elpimous/yellow_robot/Feet_mold_for_silicon.md

# Mold HowTo for Legs_V4 ONLY
 
Mold parts :
------------------

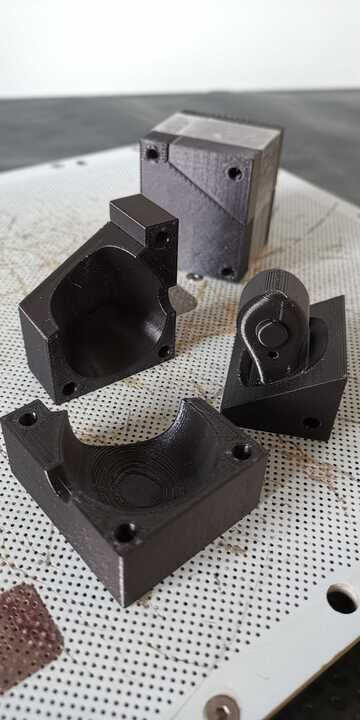
[picture p10: OpenQuad_V2/images/mold1.jpg]
Openquad

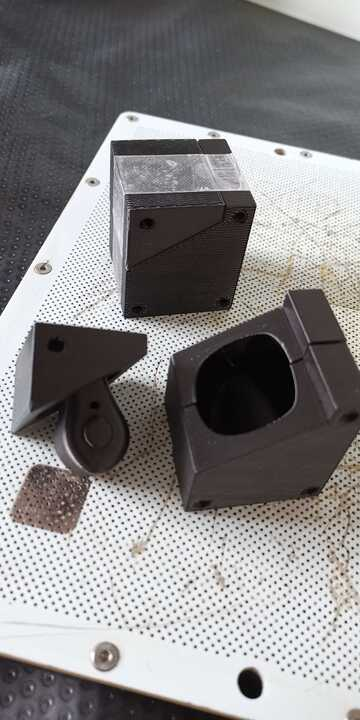
[picture p11: OpenQuad_V2/images/mold2.jpg]
Openquad


Silicon process :
------------------

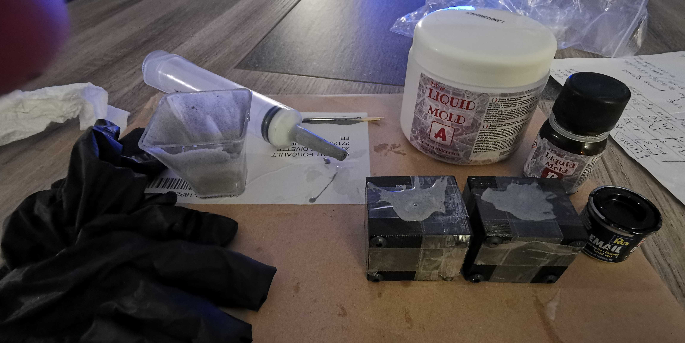
[picture p12: OpenQuad_V2/images/mold_product.jpg]
Openquad

	
No need oil or other product, to help opening mold !!

You need to clean interior mold, the better you can, 'cause the silicon prints all details !

use 100/5 :  ex. use 30grs silicon with 1.5grs hardener

you can color it (using paint for plastic parts)

Just wait at least 24h before opening mold (36h should be better ?!)

It seems that if you use a bit of acrylic paint, silicon will be dry in 5 hours ?! (didn't tested)

## After 24H...

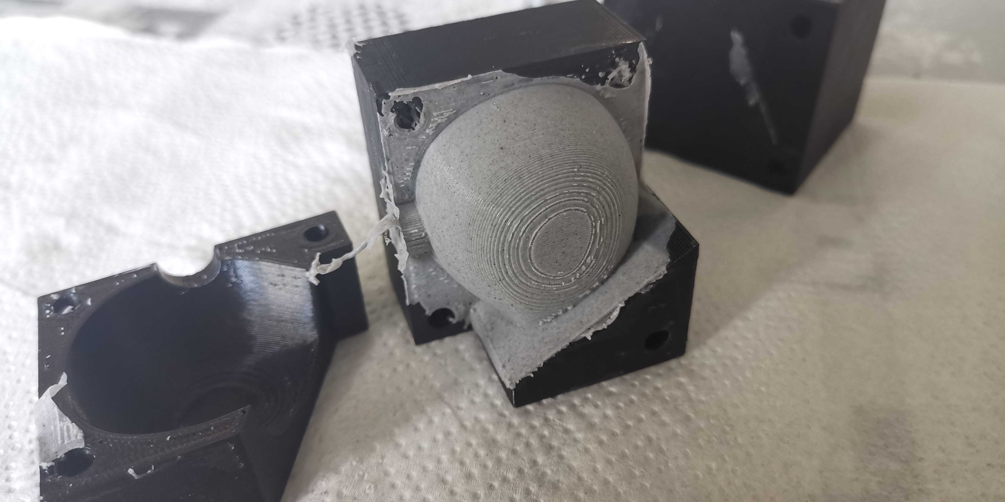
[picture p13: OpenQuad_V2/images/silicon_finished.jpg]
Openquad


Result :
--------

result is very nice, and perfect for Yellow feet !!

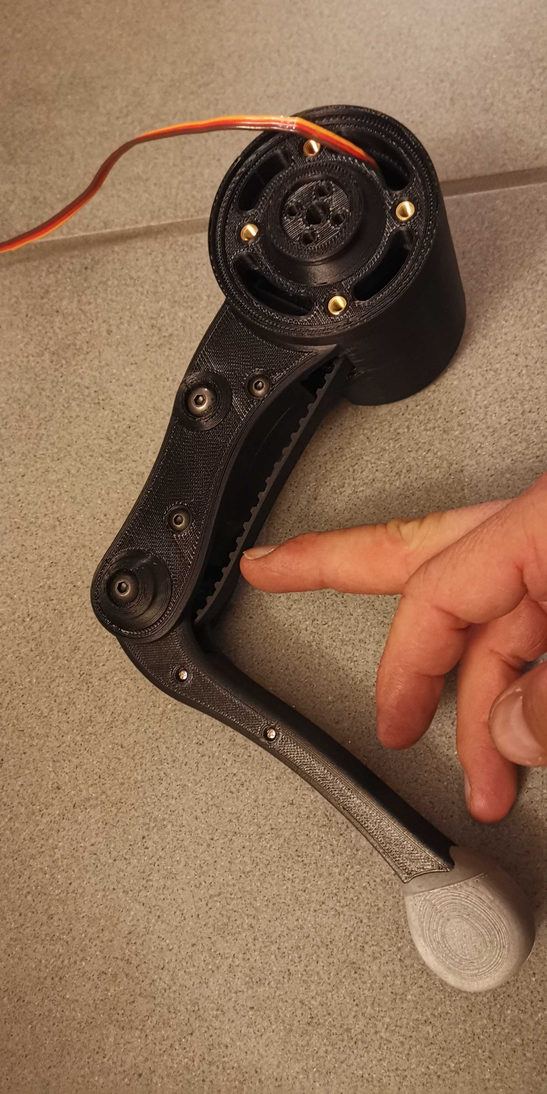
[picture p14: OpenQuad_V2/images/leg_with_silicon.jpg]
Openquad

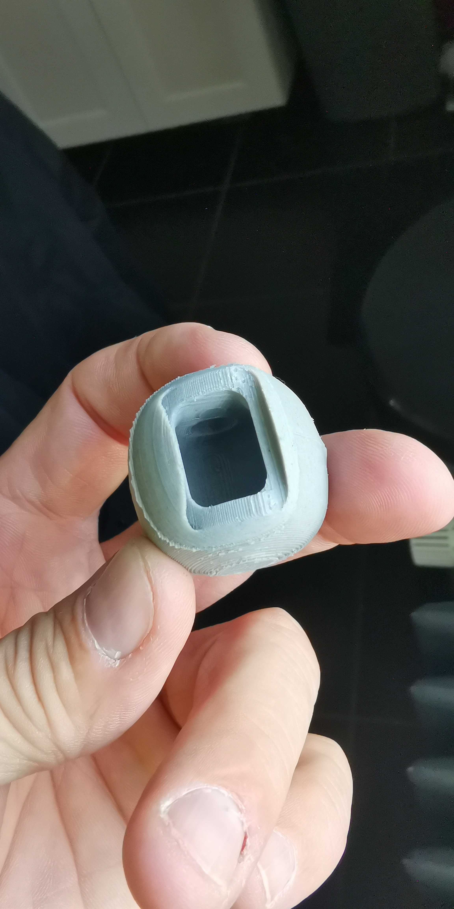
[picture p15: OpenQuad_V2/images/silicon1.jpg]
Openquad

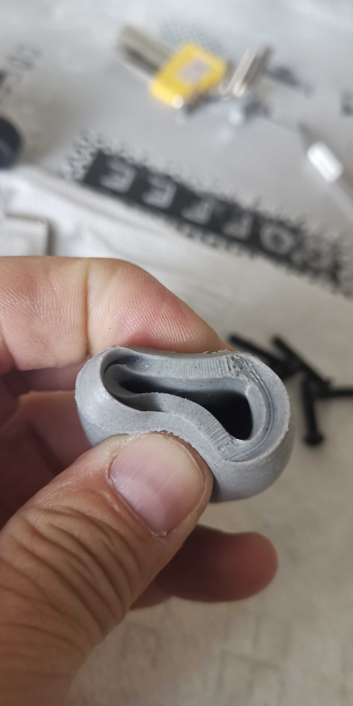
[picture p16: OpenQuad_V2/images/silicon2.jpg]
Openquad
