elpimous/yellow_robot/OpenQuad_V2/robot_parts/L_leg/img_20200823_153159.jpg

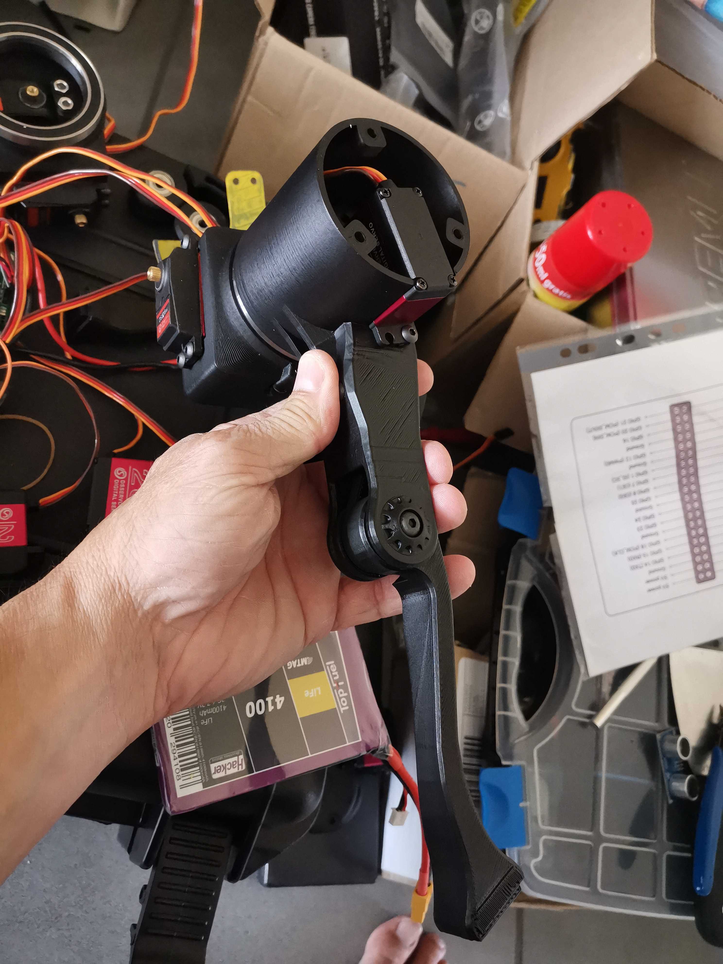
OpenQuad_V2/robot_parts/L_leg/img_20200823_153159.jpg
