elpimous/yellow_robot/OpenQuad_V2/robot_parts/L_leg/img_20200826_154630.jpg

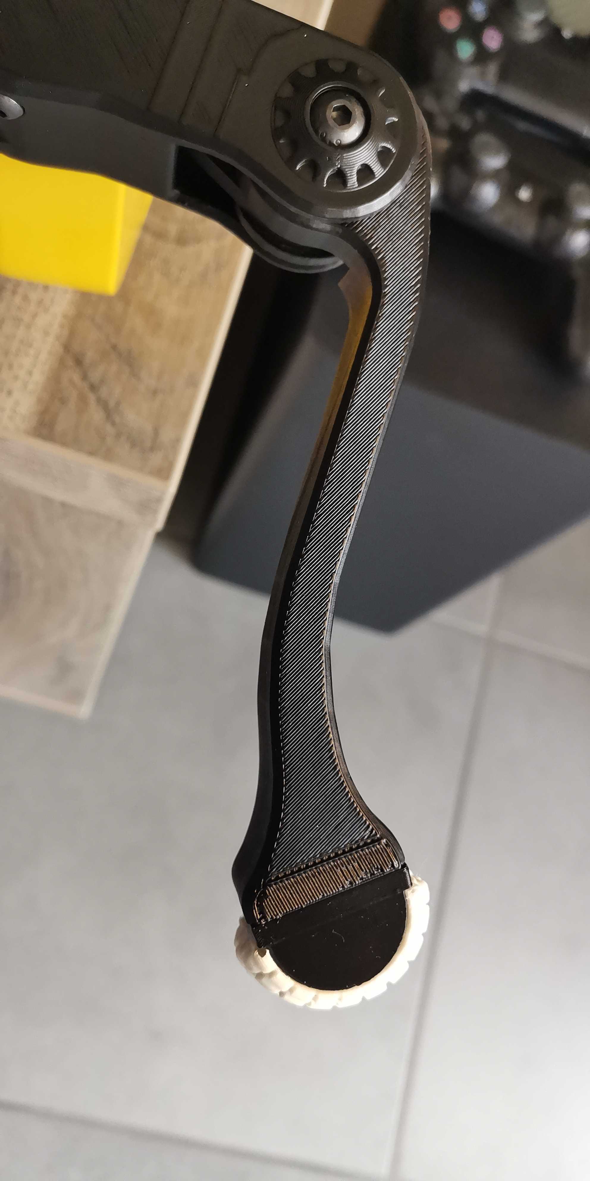
OpenQuad_V2/robot_parts/L_leg/img_20200826_154630.jpg
