elpimous/yellow_robot/OpenQuad_V2/robot_parts/R_legs_v4/img_20201010_220422.jpg

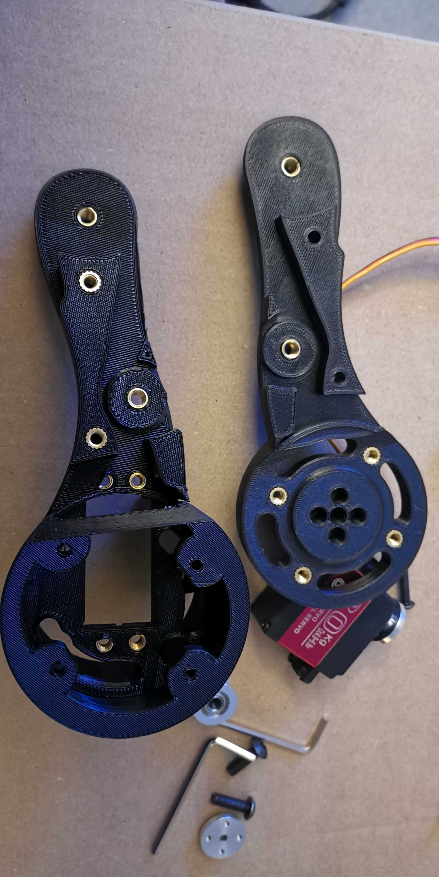
OpenQuad_V2/robot_parts/R_legs_v4/img_20201010_220422.jpg
