elpimous/yellow_robot/OpenQuad_V2/yellow_ros/src/mini_ros/stl/mainbody.stl

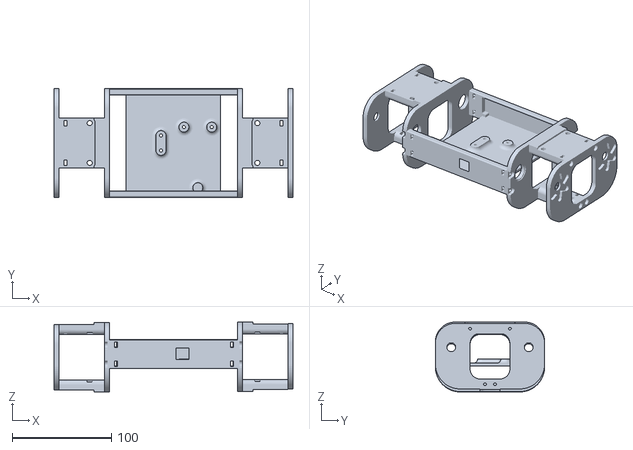
[picture p36: CAD file, 2020-09-23]
OpenQuad_V2/yellow_ros/src/mini_ros/stl/mainbody.stl
240.7 x 110.0 x 70.4
