elpimous/yellow_robot/OpenQuad_V2/yellow_ros/src/spotmicro/util/pybullet_data/assets/urdf/stl/rearmain.stl

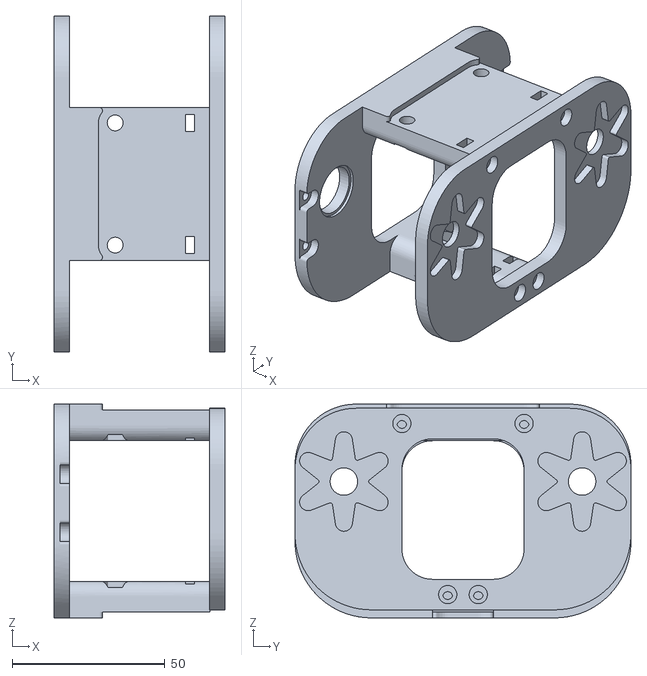
[picture p37: CAD file, 2020-09-23]
OpenQuad_V2/yellow_ros/src/spotmicro/util/pybullet_data/assets/urdf/stl/rearmain.stl
55.9 x 110.0 x 70.0
