elpimous/yellow_robot/OpenQuad_V2/yellow_ros/src/spotmicro/util/pybullet_data/assets/urdf/stl/rplidar_main.stl

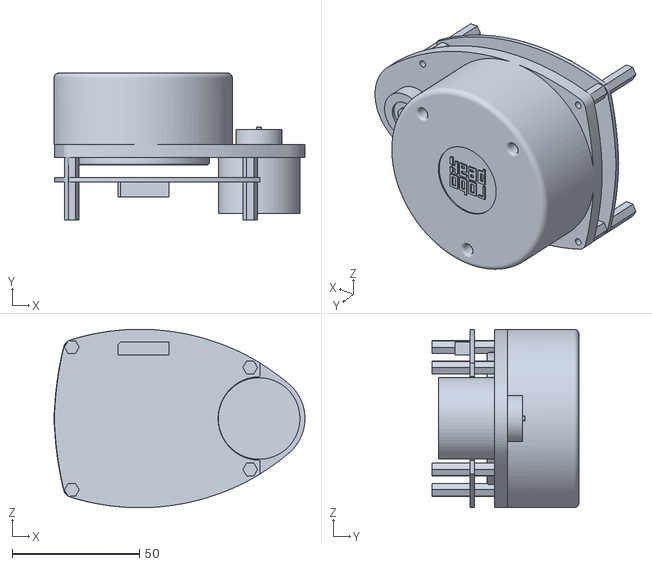
[picture p38: CAD file, 2020-09-23]
OpenQuad_V2/yellow_ros/src/spotmicro/util/pybullet_data/assets/urdf/stl/rplidar_main.stl
98.5 x 57.7 x 70.0
