elpimous/yellow_robot/OpenQuad_V2/robot_parts/body/back_cover/back_cover_v2.STL

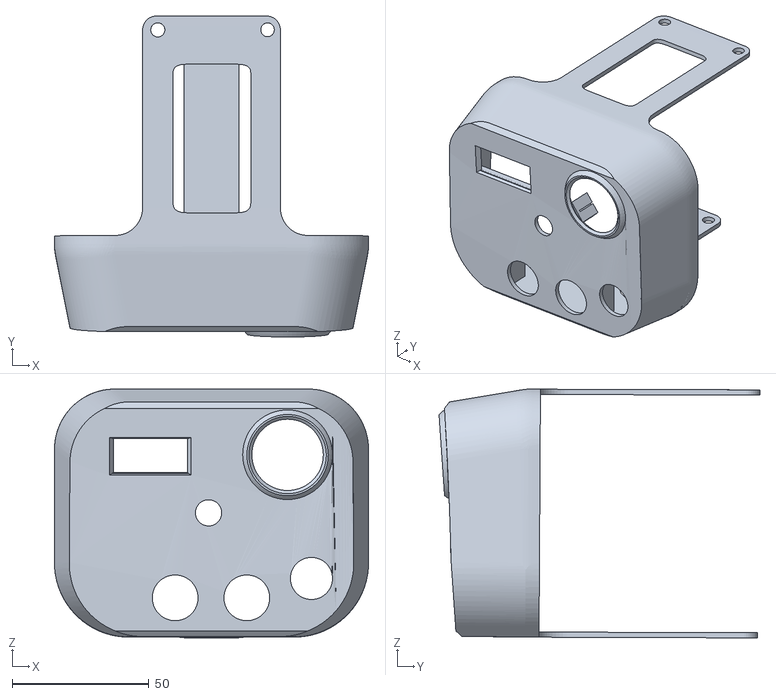
[picture p39: CAD file, 2020-08-23]
OpenQuad_V2/robot_parts/body/back_cover/back_cover_v2.STL
114.8 x 117.3 x 91.0
