elpimous/yellow_robot/OpenQuad_V2/robot_parts/body/body/RPI4+Mano_board_plateform_v2.STL

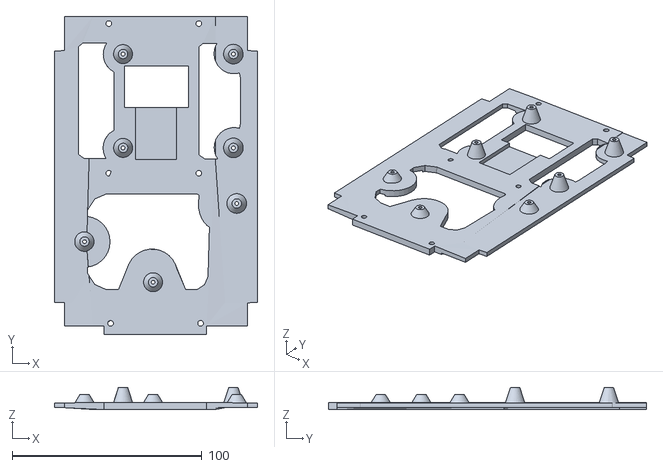
[picture p40: CAD file, 2020-09-27]
OpenQuad_V2/robot_parts/body/body/RPI4+Mano_board_plateform_v2.STL
106.9 x 167.5 x 11.6
