elpimous/yellow_robot/OpenQuad_V2/robot_parts/body/head_cover/front_cover_v2.STL

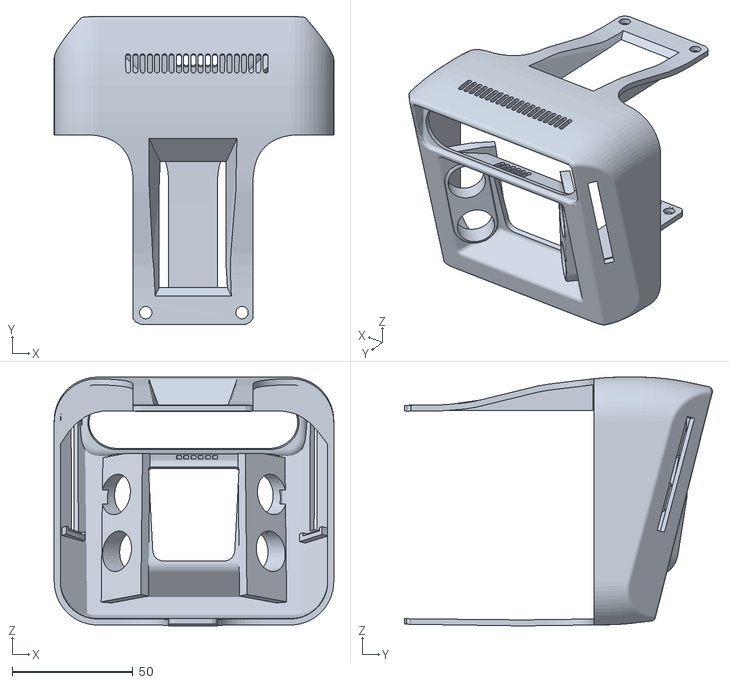
[picture p41: CAD file, 2020-10-11]
OpenQuad_V2/robot_parts/body/head_cover/front_cover_v2.STL
116.0 x 127.8 x 103.2
