elpimous/yellow_robot/OpenQuad_V2/robot_parts/L_leg/hip_v2.STL

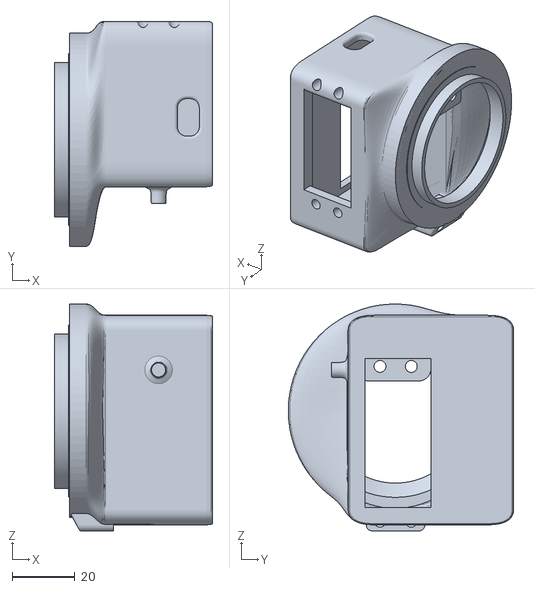
[picture p42: CAD file, 2020-08-23]
OpenQuad_V2/robot_parts/L_leg/hip_v2.STL
50.6 x 72.1 x 72.6
