elpimous/yellow_robot/OpenQuad_V2/robot_parts/R_legs_v4/R_shoulder_1-2.stl

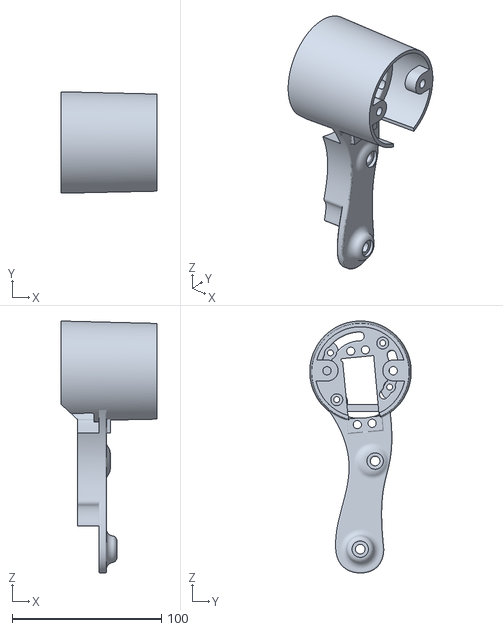
[picture p43: CAD file, 2020-10-18]
OpenQuad_V2/robot_parts/R_legs_v4/R_shoulder_1-2.stl
64.2 x 68.1 x 169.1
