elpimous/yellow_robot/OpenQuad_V2/robot_parts/universel/foot_mold_for_V4_legs/mold_2-2.stl

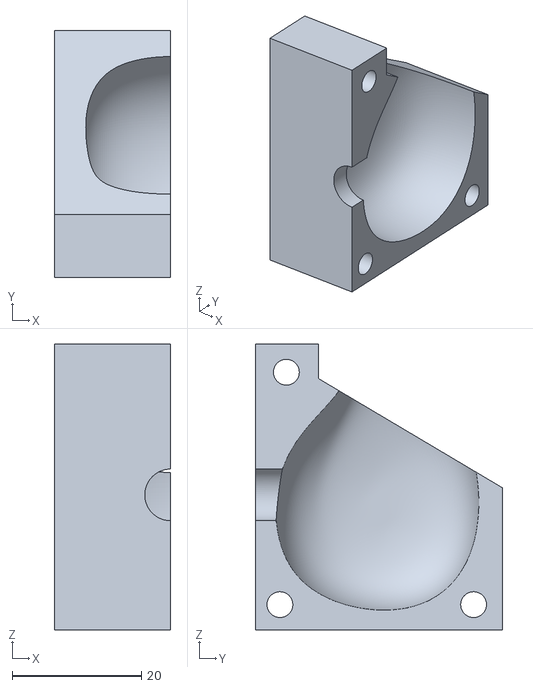
[picture p44: CAD file, 2020-10-21]
OpenQuad_V2/robot_parts/universel/foot_mold_for_V4_legs/mold_2-2.stl
18.0 x 38.2 x 44.3
