elpimous/yellow_robot/OpenQuad_V2/robot_parts/universel/leg_pulley_for_V4.stl

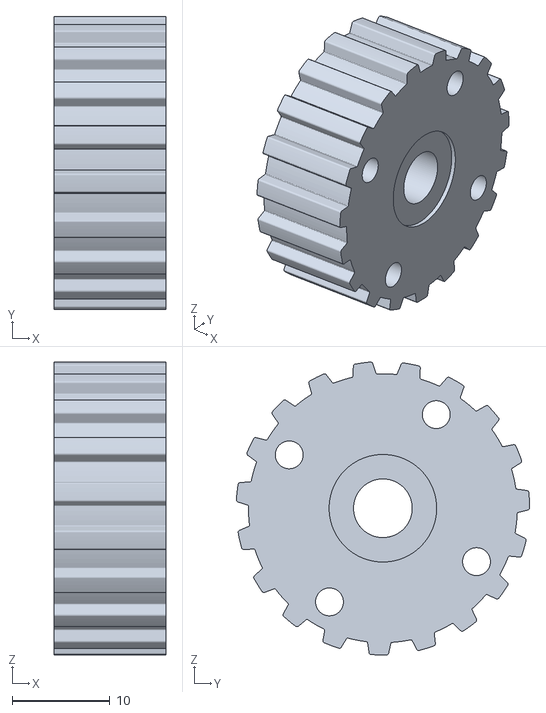
[picture p45: CAD file, 2020-10-21]
OpenQuad_V2/robot_parts/universel/leg_pulley_for_V4.stl
11.4 x 30.0 x 30.0
