elpimous/yellow_robot/OpenQuad_V2/robot_parts/universel/stl_parts_for_3d_soft/Neopixel8x.stl

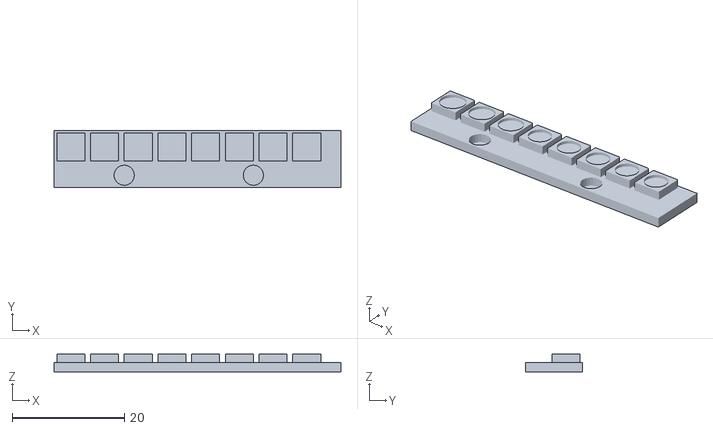
[picture p46: CAD file, 2020-09-03]
OpenQuad_V2/robot_parts/universel/stl_parts_for_3d_soft/Neopixel8x.stl
51.1 x 10.2 x 3.20
