elpimous/yellow_robot/OpenQuad_V2/yellow_ros/src/mini_ros/stl/OpenQuadruped/SERVO_WITH_COVER.stl

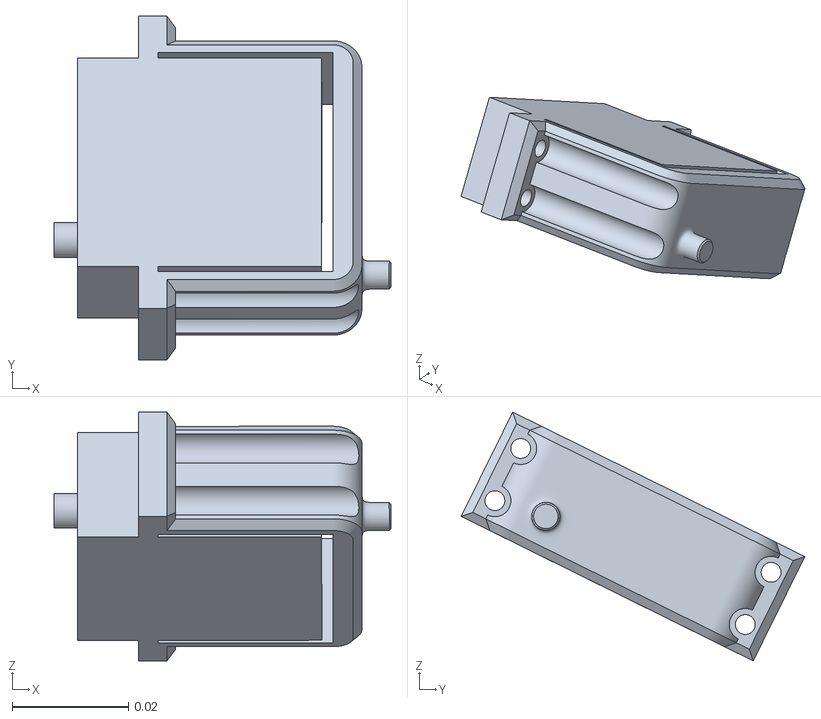
[picture p47: CAD file, 2020-09-23]
OpenQuad_V2/yellow_ros/src/mini_ros/stl/OpenQuadruped/SERVO_WITH_COVER.stl
0.0579 x 0.0591 x 0.0428
