elpimous/yellow_robot/OpenQuad_V2/yellow_ros/src/spot_bullet/src/mini_bullet/terrain9735.obj

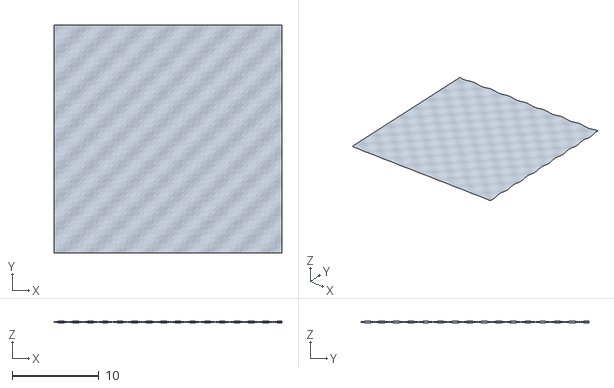
[picture p48: CAD file, 2020-09-23]
OpenQuad_V2/yellow_ros/src/spot_bullet/src/mini_bullet/terrain9735.obj
26.3 x 26.3 x 0.24
