elpimous/yellow_robot/OpenQuad_V2/yellow_ros/src/spotmicro/util/pybullet_data/assets/urdf/stl/backpart.stl

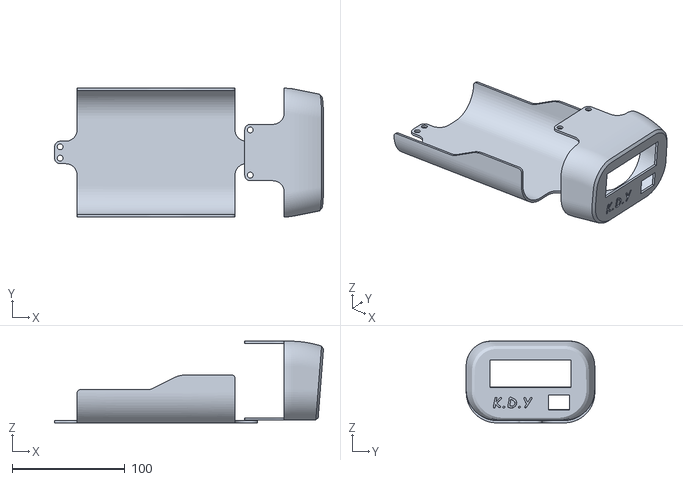
[picture p49: CAD file, 2020-09-23]
OpenQuad_V2/yellow_ros/src/spotmicro/util/pybullet_data/assets/urdf/stl/backpart.stl
238.4 x 114.1 x 72.5
