elpimous/yellow_robot/OpenQuad_V2/yellow_ros/src/spotmicro/util/pybullet_data/assets/urdf/stl/OpenQuadruped/RIGHT_HIP.stl

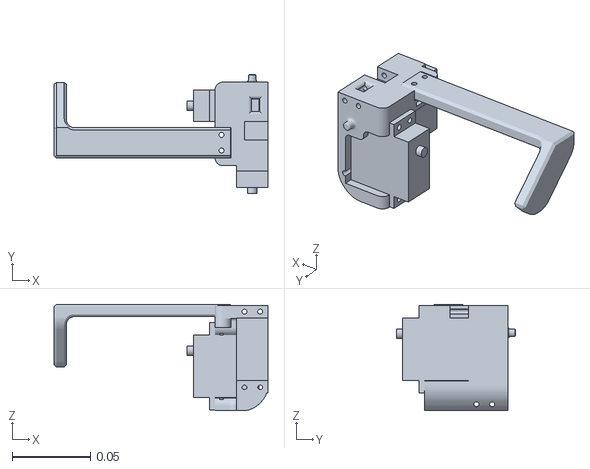
[picture p50: CAD file, 2020-09-23]
OpenQuad_V2/yellow_ros/src/spotmicro/util/pybullet_data/assets/urdf/stl/OpenQuadruped/RIGHT_HIP.stl
0.137 x 0.0762 x 0.068
