elpimous/yellow_robot/OpenQuad_V2/yellow_ros/src/spotmicro/util/pybullet_data/plane100.obj

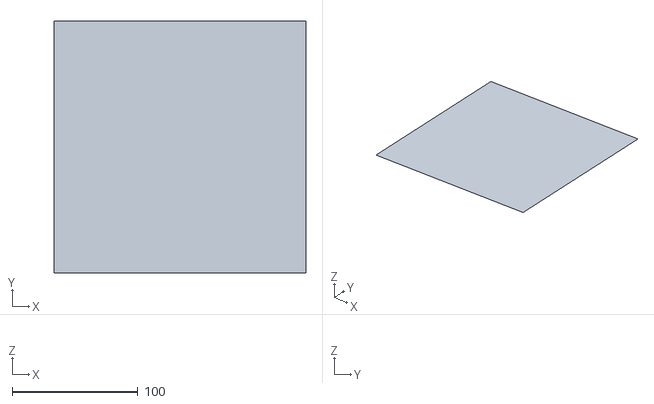
[picture p51: CAD file, 2020-09-23]
OpenQuad_V2/yellow_ros/src/spotmicro/util/pybullet_data/plane100.obj
200.0 x 200.0 x 0
