elpimous/yellow_robot/OpenQuad_V2/robot_parts/body/body/D435_fix_plate_v2.STL

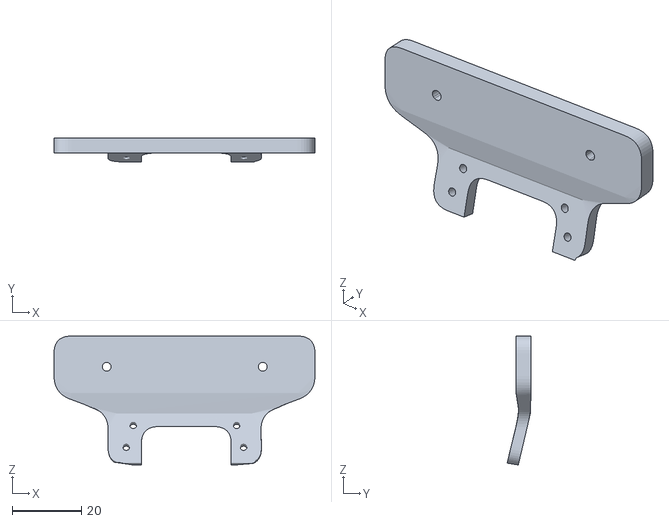
[picture p52: CAD file, 2020-09-03]
OpenQuad_V2/robot_parts/body/body/D435_fix_plate_v2.STL
75.2 x 6.87 x 37.1
