elpimous/yellow_robot/OpenQuad_V2/robot_parts/body/body_cover/bottom_cover_v2_2-2.STL

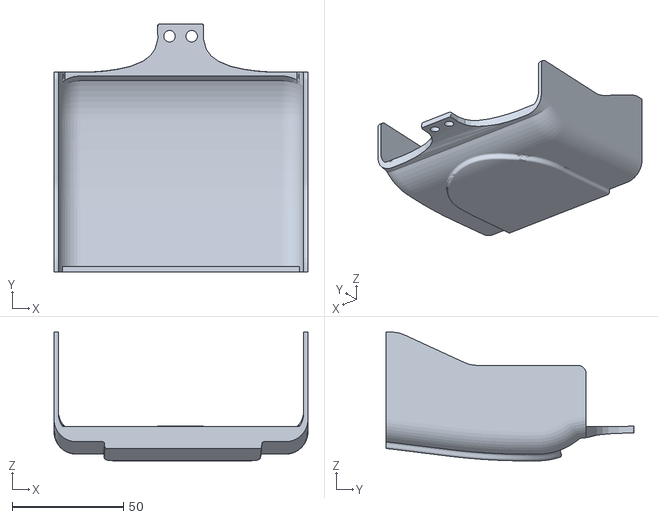
[picture p53: CAD file, 2020-09-03]
OpenQuad_V2/robot_parts/body/body_cover/bottom_cover_v2_2-2.STL
114.0 x 111.5 x 57.8
