elpimous/yellow_robot/OpenQuad_V2/robot_parts/body/head_cover/head_speaker_grill_v2.STL

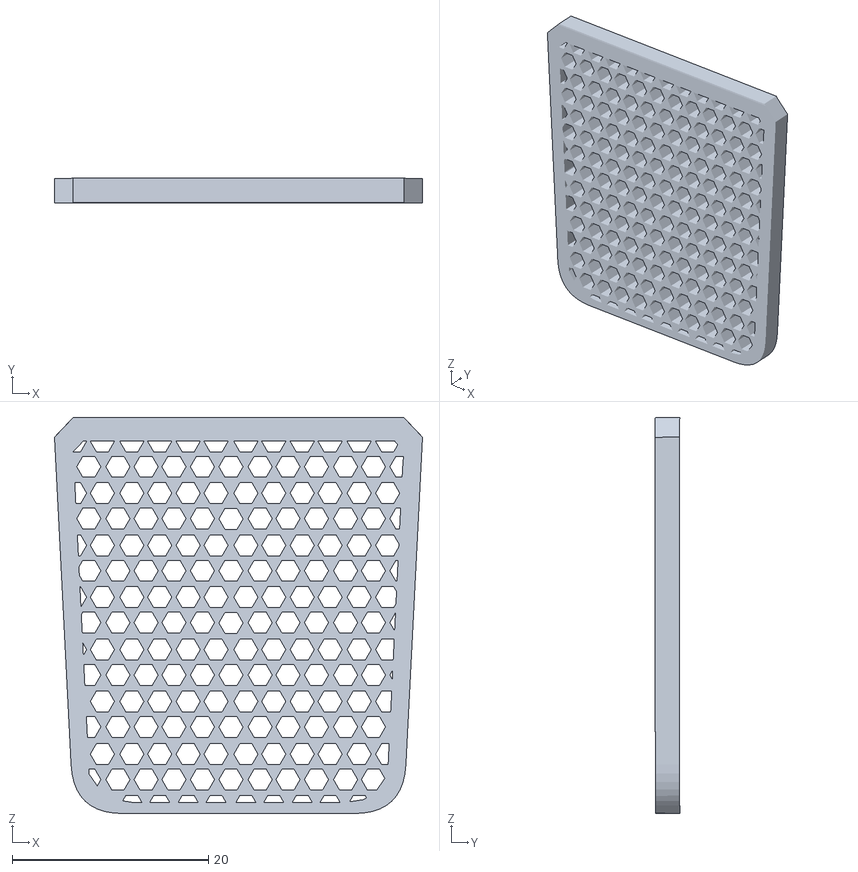
[picture p54: CAD file, 2020-09-03]
OpenQuad_V2/robot_parts/body/head_cover/head_speaker_grill_v2.STL
37.5 x 2.53 x 40.3
