elpimous/yellow_robot/OpenQuad_V2/robot_parts/L_leg/shoulder_cover_v2.STL

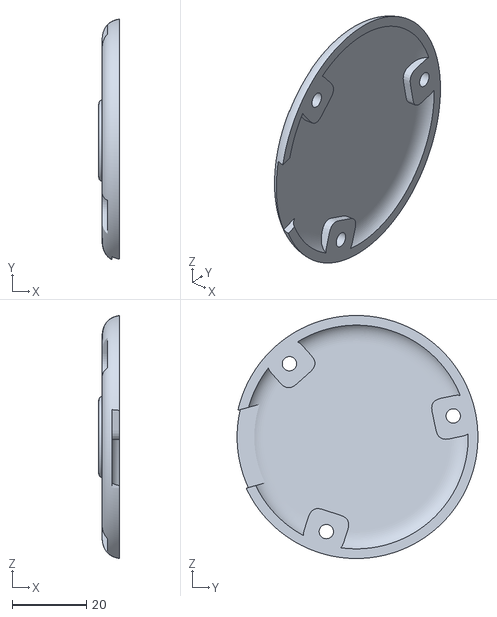
[picture p55: CAD file, 2020-08-23]
OpenQuad_V2/robot_parts/L_leg/shoulder_cover_v2.STL
5.58 x 64.8 x 65.4
