elpimous/yellow_robot/OpenQuad_V2/robot_parts/R_legs_v4/R_leg_2-2.stl

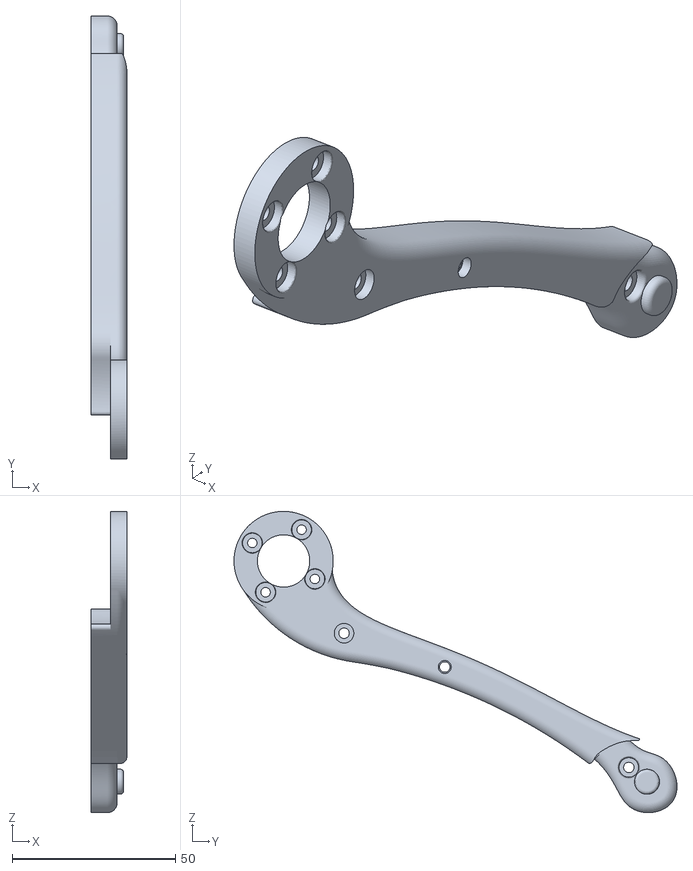
[picture p56: CAD file, 2020-10-18]
OpenQuad_V2/robot_parts/R_legs_v4/R_leg_2-2.stl
11.0 x 135.6 x 92.2
