elpimous/yellow_robot/OpenQuad_V2/robot_parts/universel/foot_mold_for_V4_legs/upper_mold_part.stl

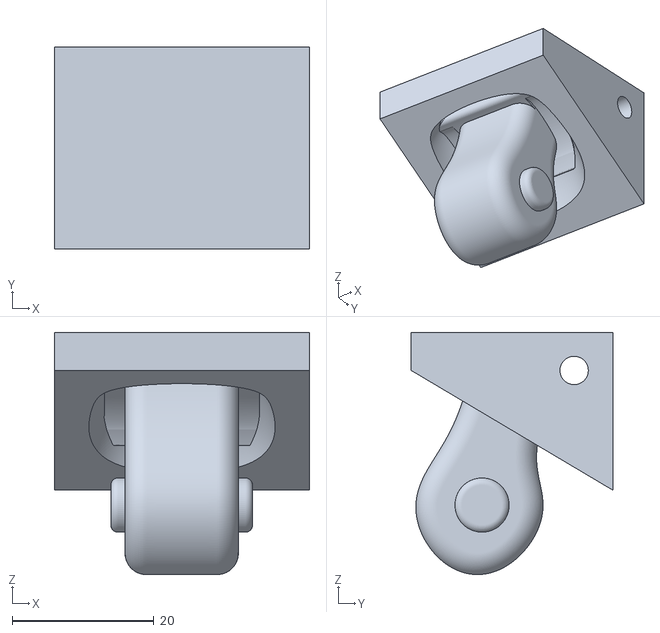
[picture p57: CAD file, 2020-10-21]
OpenQuad_V2/robot_parts/universel/foot_mold_for_V4_legs/upper_mold_part.stl
36.0 x 28.5 x 34.2
