elpimous/yellow_robot/OpenQuad_V2/robot_parts/universel/shoulder_pulley_for_V4.stl

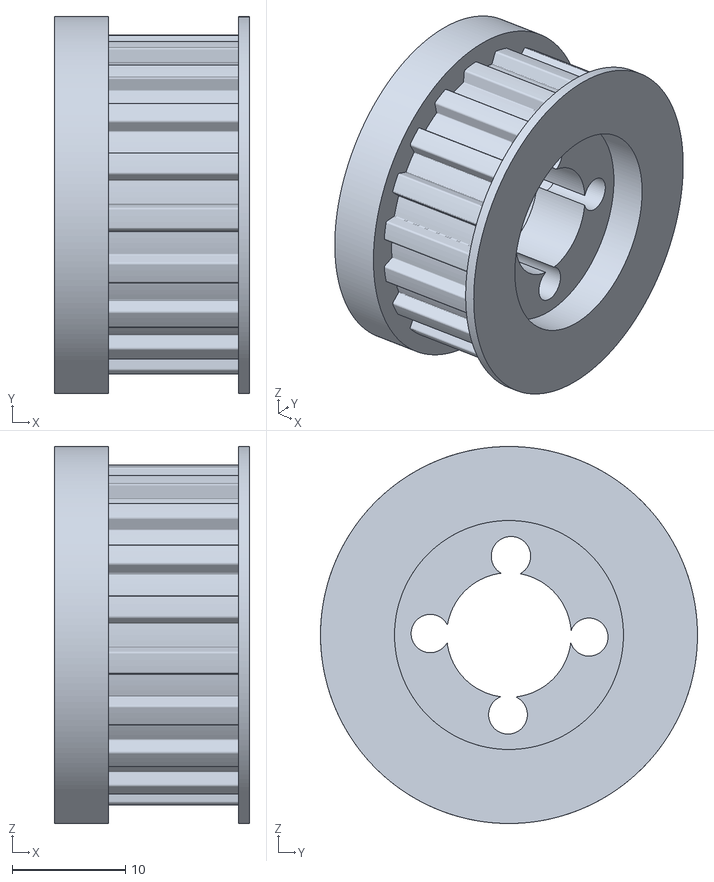
[picture p58: CAD file, 2020-10-18]
OpenQuad_V2/robot_parts/universel/shoulder_pulley_for_V4.stl
17.2 x 33.3 x 33.3
