elpimous/yellow_robot/OpenQuad_V2/robot_parts/universel/stl_parts_for_3d_soft/roulement16-5-5 v1.stl

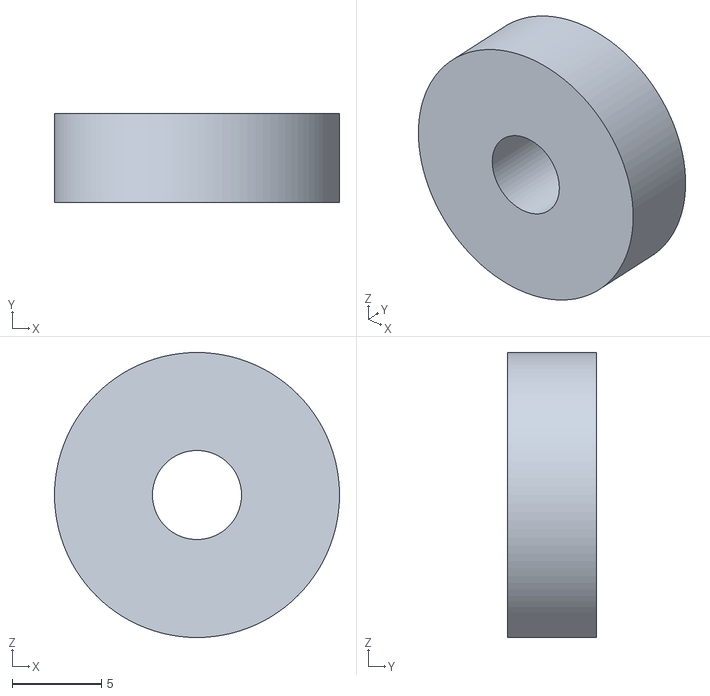
[picture p59: CAD file, 2020-08-23]
OpenQuad_V2/robot_parts/universel/stl_parts_for_3d_soft/roulement16-5-5 v1.stl
16.0 x 5.00 x 16.0
