elpimous/yellow_robot/OpenQuad_V2/yellow_ros/src/mini_ros/stl/OpenQuadruped/BACK.stl

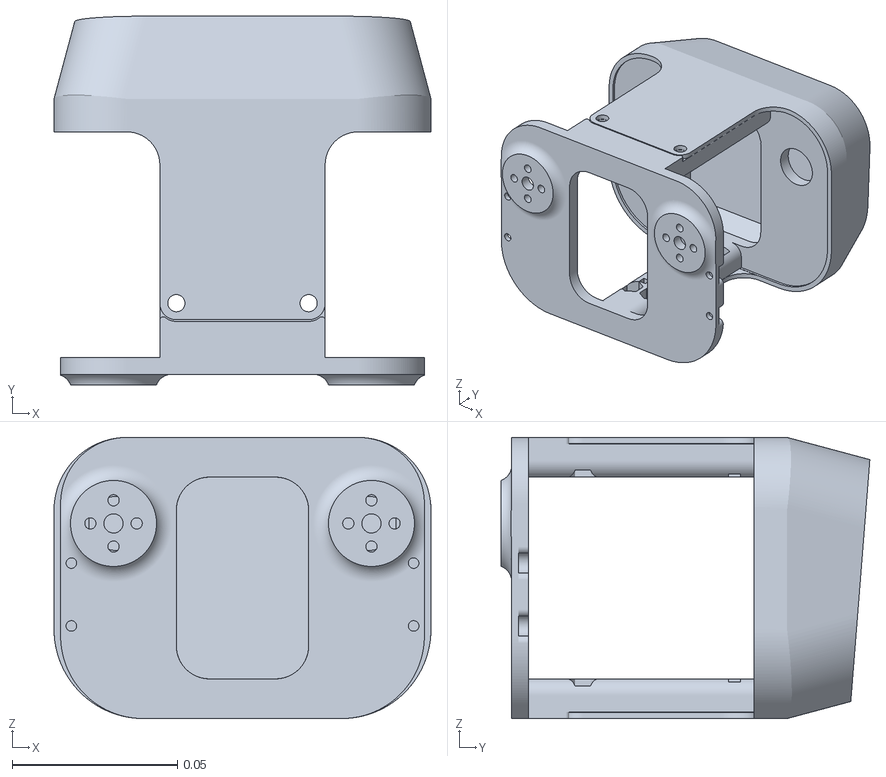
[picture p60: CAD file, 2020-09-23]
OpenQuad_V2/yellow_ros/src/mini_ros/stl/OpenQuadruped/BACK.stl
0.114 x 0.112 x 0.085
