elpimous/yellow_robot/OpenQuad_V2/yellow_ros/src/spotmicro/util/pybullet_data/assets/urdf/stl/OpenQuadruped/Chassis_Right_Side.stl

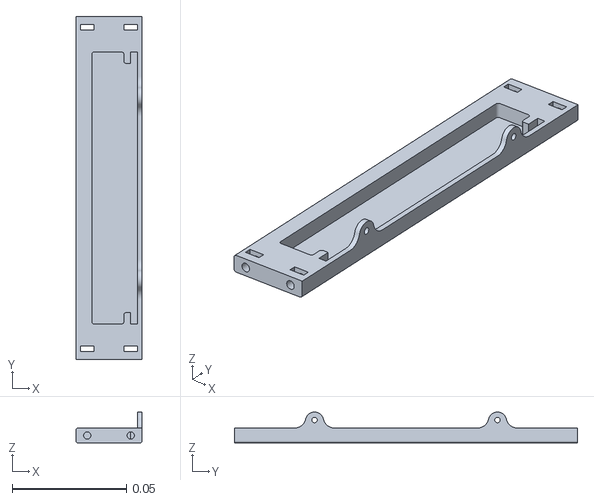
[picture p61: CAD file, 2020-09-23]
OpenQuad_V2/yellow_ros/src/spotmicro/util/pybullet_data/assets/urdf/stl/OpenQuadruped/Chassis_Right_Side.stl
0.029 x 0.15 x 0.0135
