elpimous/yellow_robot/OpenQuad_V2/robot_parts/body/body/front_out_plate_v2.STL

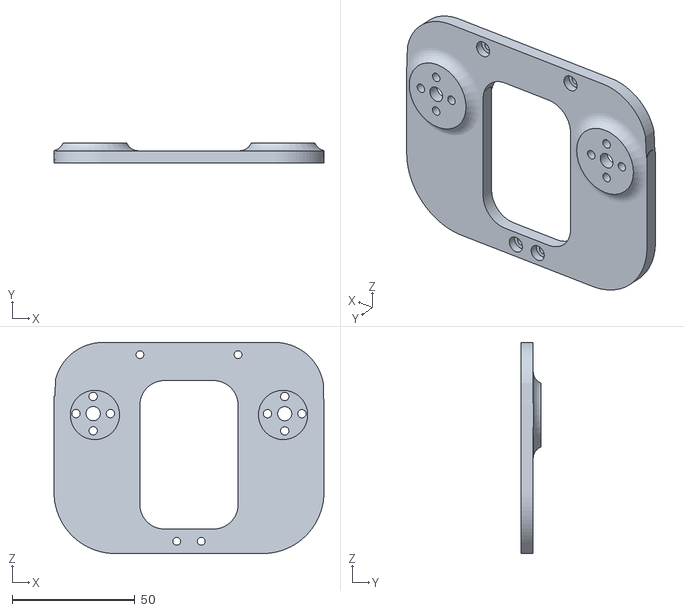
[picture p63: CAD file, 2020-08-23]
OpenQuad_V2/robot_parts/body/body/front_out_plate_v2.STL
110.0 x 8.20 x 86.0
