elpimous/yellow_robot/OpenQuad_V2/robot_parts/body/body_cover/handle_v2.STL

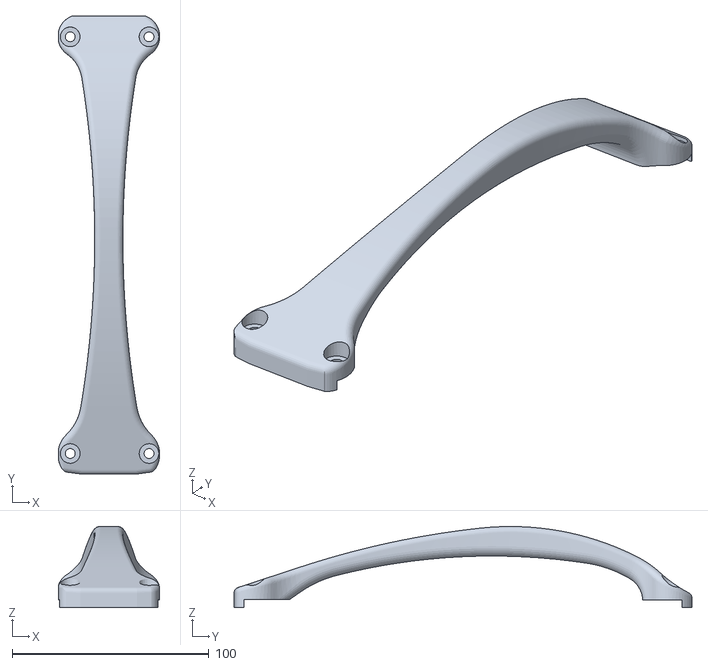
[picture p64: CAD file, 2020-08-23]
OpenQuad_V2/robot_parts/body/body_cover/handle_v2.STL
51.5 x 232.5 x 41.1
