elpimous/yellow_robot/OpenQuad_V2/robot_parts/body/head_cover/head_speaker_fix_plate_v2.STL

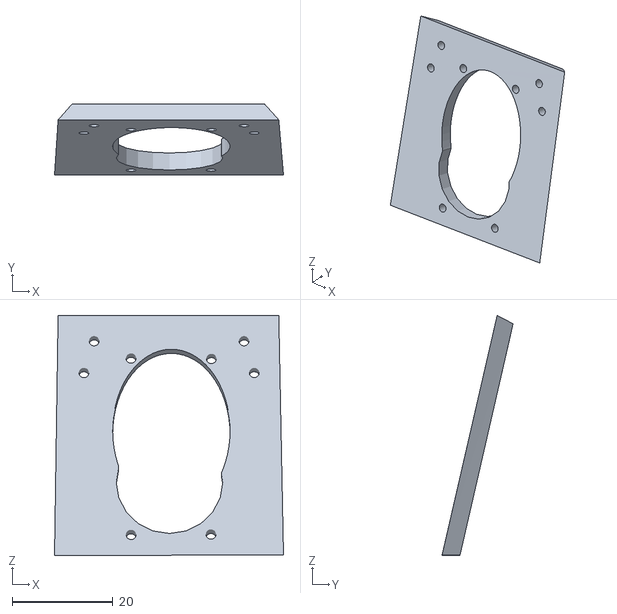
[picture p65: CAD file, 2020-09-03]
OpenQuad_V2/robot_parts/body/head_cover/head_speaker_fix_plate_v2.STL
45.5 x 14.1 x 47.7
