elpimous/yellow_robot/OpenQuad_V2/robot_parts/L_leg/shoulder_v2.STL

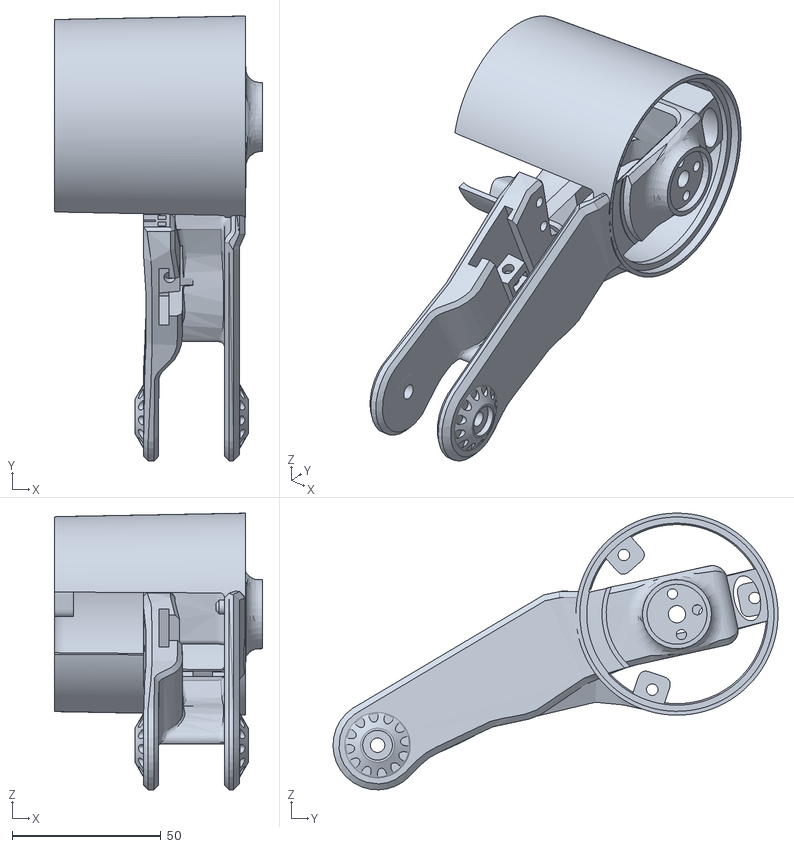
[picture p66: CAD file, 2020-08-23]
OpenQuad_V2/robot_parts/L_leg/shoulder_v2.STL
70.0 x 149.6 x 93.0
