elpimous/yellow_robot/OpenQuad_V2/robot_parts/universel/stl_parts_for_3d_soft/DS3218MG_servo_object.STL

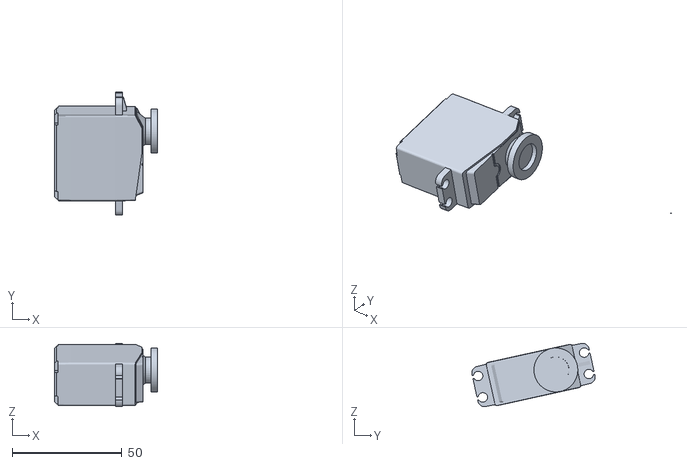
[picture p68: CAD file, 2020-08-23]
OpenQuad_V2/robot_parts/universel/stl_parts_for_3d_soft/DS3218MG_servo_object.STL
123.6 x 56.3 x 28.9
