elpimous/yellow_robot/OpenQuad_V2/yellow_ros/src/mini_ros/stl/foot.stl

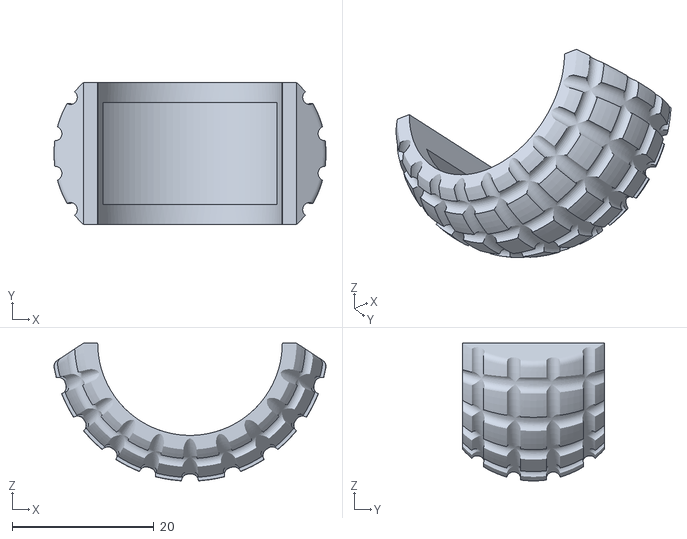
[picture p69: CAD file, 2020-09-23]
OpenQuad_V2/yellow_ros/src/mini_ros/stl/foot.stl
38.3 x 20.0 x 19.4
