elpimous/yellow_robot/OpenQuad_V2/yellow_ros/src/mini_ros/stl/OpenQuadruped/Front_Bracket.stl

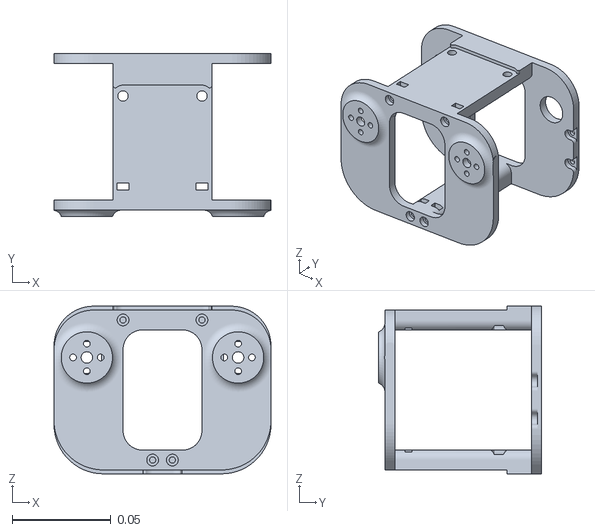
[picture p70: CAD file, 2020-09-23]
OpenQuad_V2/yellow_ros/src/mini_ros/stl/OpenQuadruped/Front_Bracket.stl
0.11 x 0.0825 x 0.085
