elpimous/yellow_robot/OpenQuad_V2/robot_parts/body/body/plateform_right_side_v2.stl

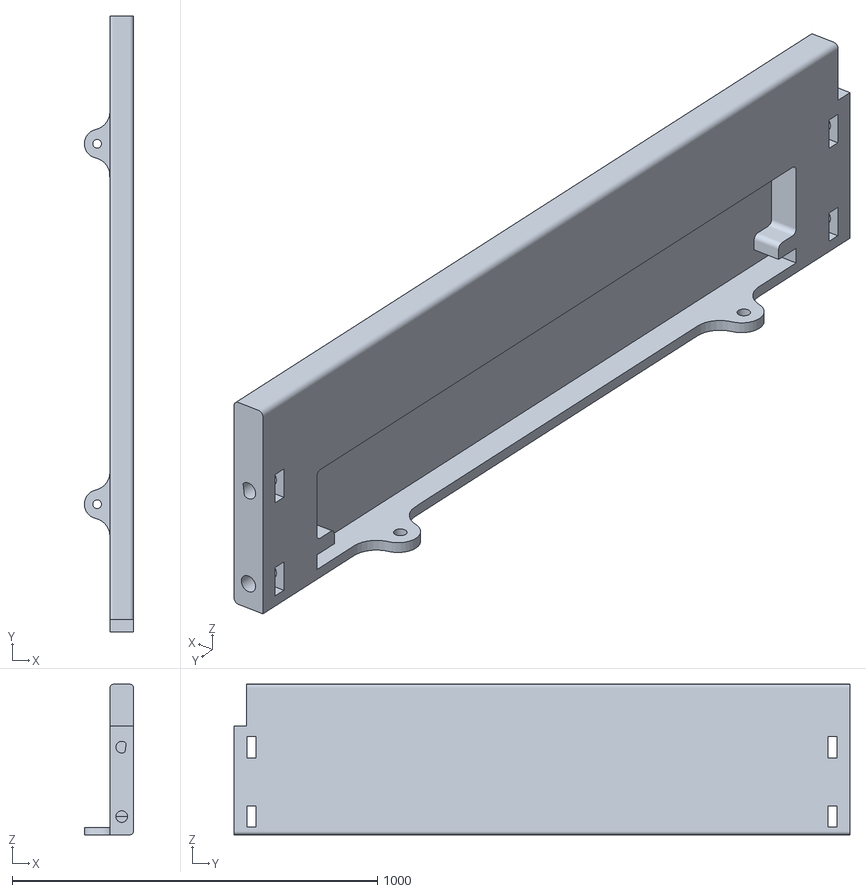
[picture p72: CAD file, 2020-08-23]
OpenQuad_V2/robot_parts/body/body/plateform_right_side_v2.stl
135.0 x 1687.5 x 412.5
