elpimous/yellow_robot/OpenQuad_V2/robot_parts/body/body_cover/top_cover_v2.STL

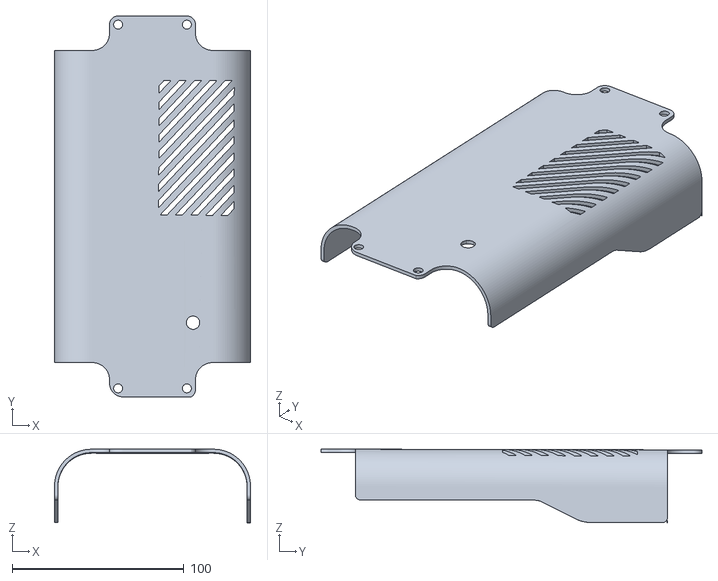
[picture p73: CAD file, 2020-08-23]
OpenQuad_V2/robot_parts/body/body_cover/top_cover_v2.STL
114.0 x 221.6 x 42.9
