elpimous/yellow_robot/OpenQuad_V2/robot_parts/L_leg/leg_v2.STL

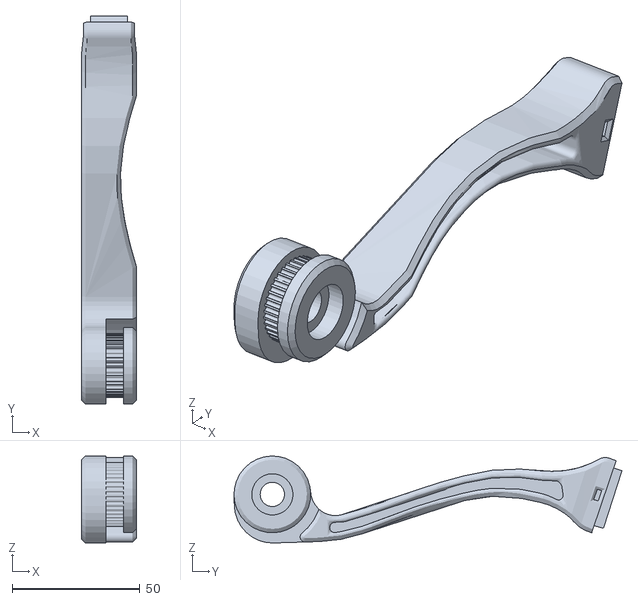
[picture p74: CAD file, 2020-08-23]
OpenQuad_V2/robot_parts/L_leg/leg_v2.STL
21.4 x 151.6 x 34.0
