elpimous/yellow_robot/OpenQuad_V2/robot_parts/R_legs_v4/R_shoulder_2-2.stl

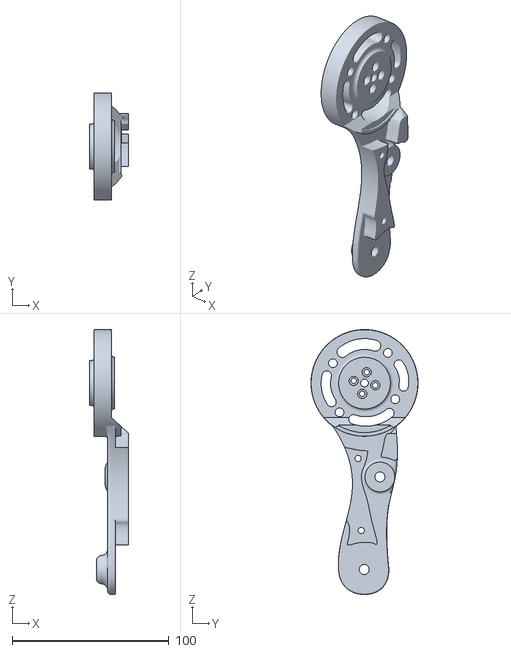
[picture p75: CAD file, 2020-10-18]
OpenQuad_V2/robot_parts/R_legs_v4/R_shoulder_2-2.stl
25.2 x 68.4 x 169.2
