elpimous/yellow_robot/OpenQuad_V2/robot_parts/universel/electronic_fix_part.STL

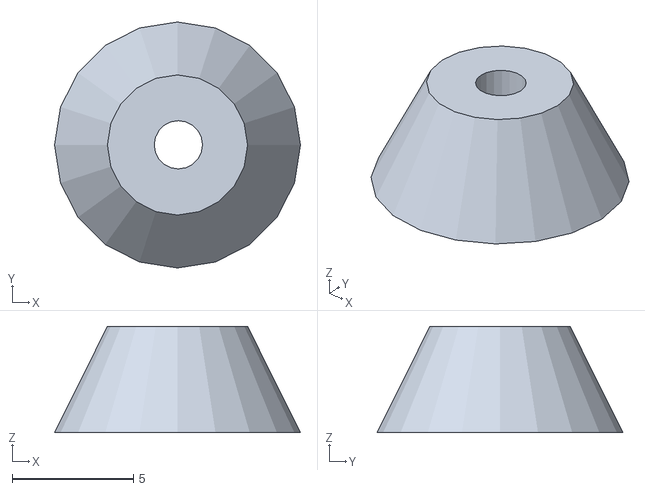
[picture p76: CAD file, 2020-09-03]
OpenQuad_V2/robot_parts/universel/electronic_fix_part.STL
10.2 x 10.2 x 4.39
