elpimous/yellow_robot/OpenQuad_V2/robot_parts/universel/stl_parts_for_3d_soft/VIS_M5 v1.stl

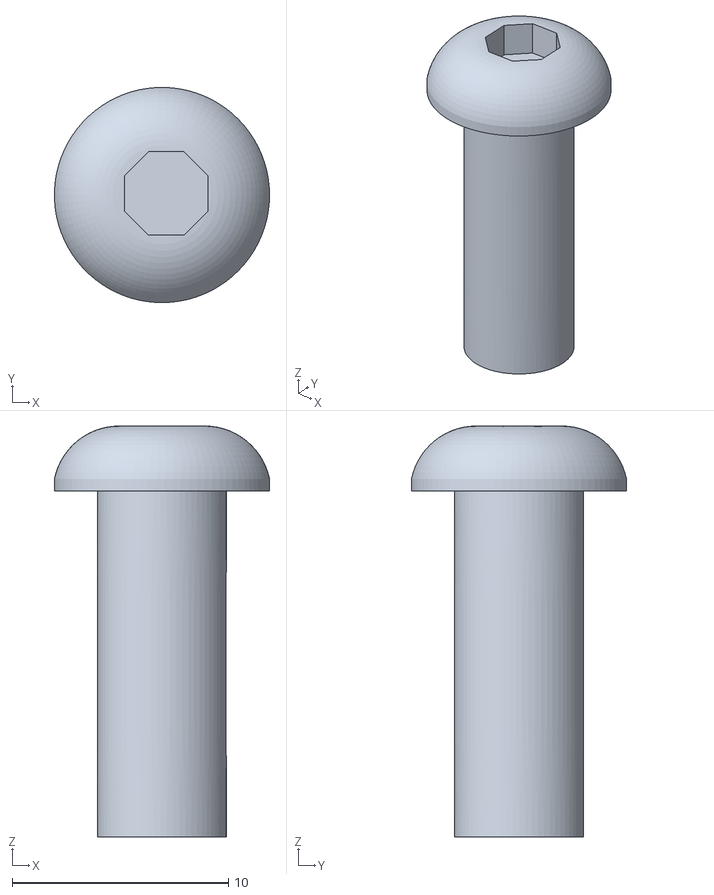
[picture p77: CAD file, 2020-08-23]
OpenQuad_V2/robot_parts/universel/stl_parts_for_3d_soft/VIS_M5 v1.stl
9.95 x 9.95 x 19.0
