elpimous/yellow_robot/OpenQuad_V2/yellow_ros/src/mini_ros/stl/larm.stl

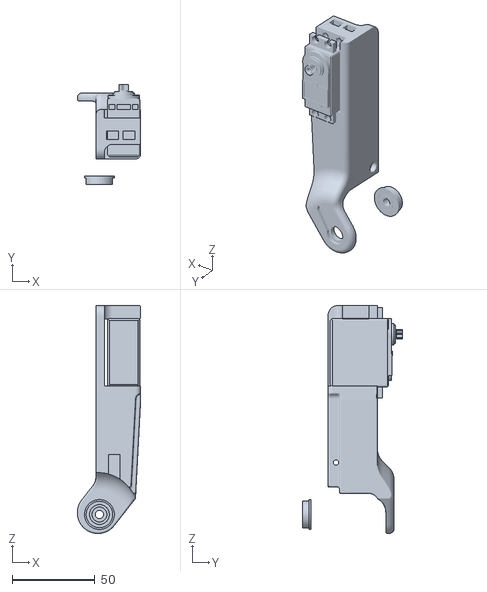
[picture p78: CAD file, 2020-09-23]
OpenQuad_V2/yellow_ros/src/mini_ros/stl/larm.stl
38.2 x 60.2 x 137.4
