elpimous/yellow_robot/OpenQuad_V2/robot_parts/body/body/back_out_plate_v2.STL

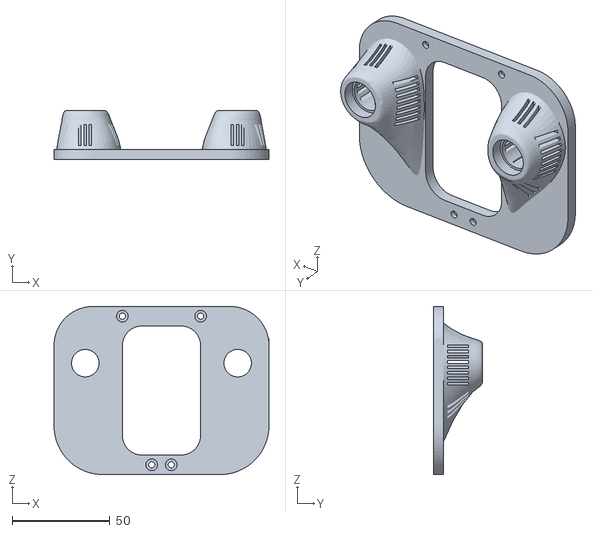
[picture p80: CAD file, 2020-08-23]
OpenQuad_V2/robot_parts/body/body/back_out_plate_v2.STL
110.0 x 24.9 x 86.0
