elpimous/yellow_robot/OpenQuad_V2/robot_parts/R_legs_v4/R_shoulder_cover.stl

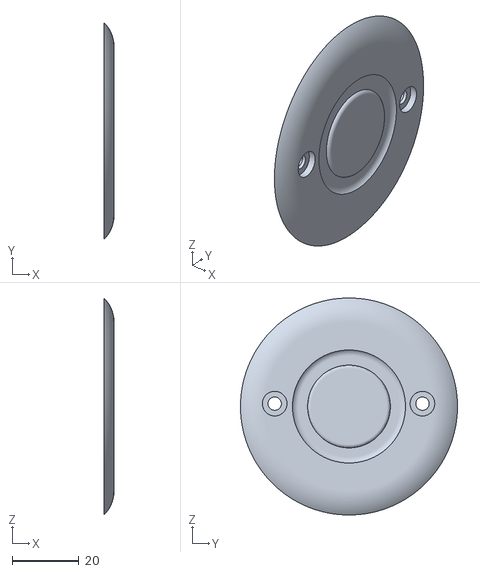
[picture p81: CAD file, 2020-10-18]
OpenQuad_V2/robot_parts/R_legs_v4/R_shoulder_cover.stl
3.03 x 65.1 x 65.1
