elpimous/yellow_robot/OpenQuad_V2/robot_parts/universel/foot_adaptator_spotmicro2openquad.STL

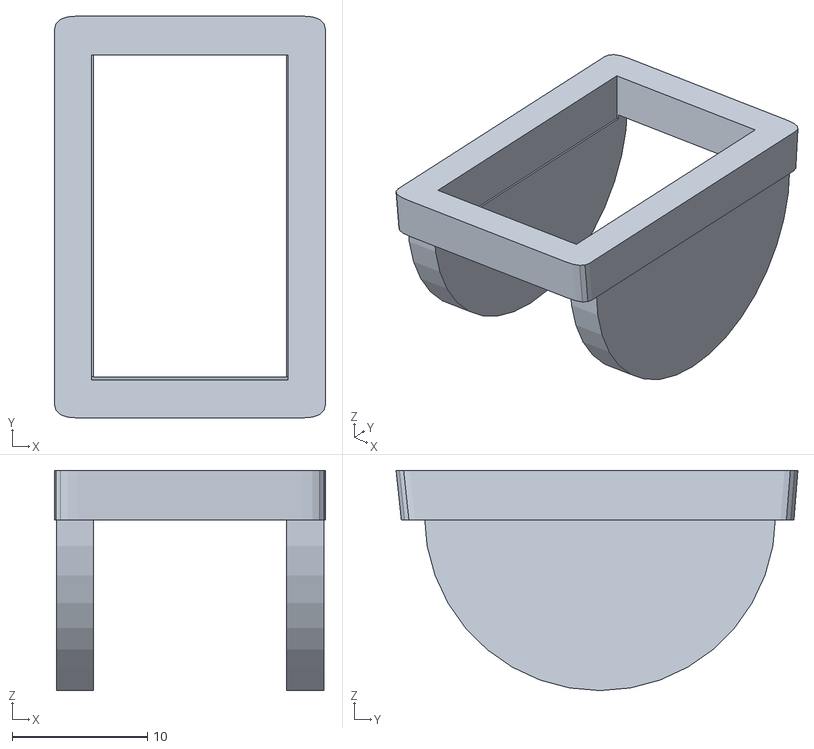
[picture p82: CAD file, 2020-09-03]
OpenQuad_V2/robot_parts/universel/foot_adaptator_spotmicro2openquad.STL
20.0 x 29.7 x 16.3
