elpimous/yellow_robot/OpenQuad_V2/robot_parts/universel/stl_parts_for_3d_soft/belt_bearing_tensioner_for_v2.STL

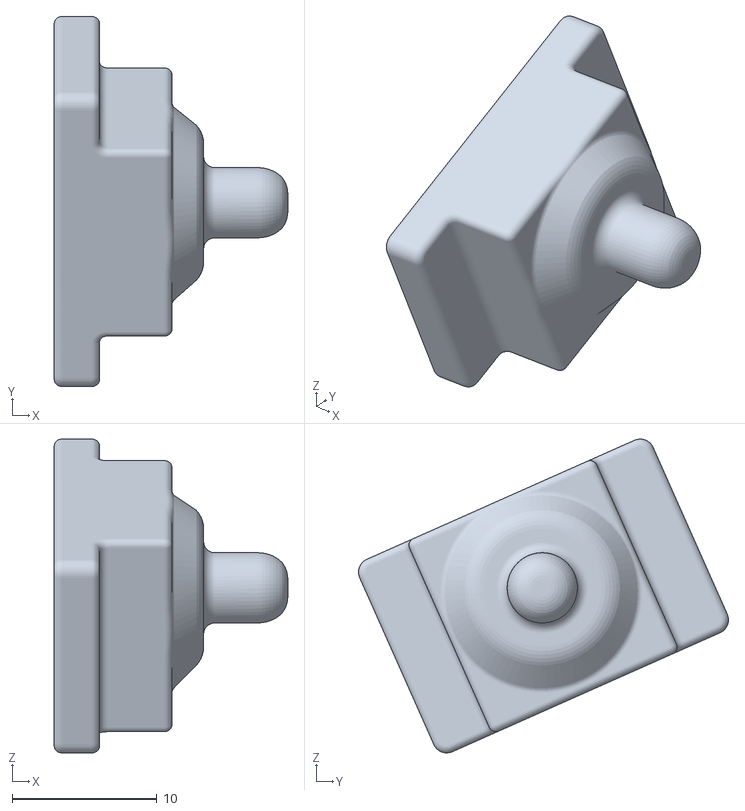
[picture p83: CAD file, 2020-08-23]
OpenQuad_V2/robot_parts/universel/stl_parts_for_3d_soft/belt_bearing_tensioner_for_v2.STL
16.2 x 25.6 x 21.7
