elpimous/yellow_robot/OpenQuad_V2/yellow_ros/src/mini_ros/stl/OpenQuadruped/LEFT_FOOT.stl

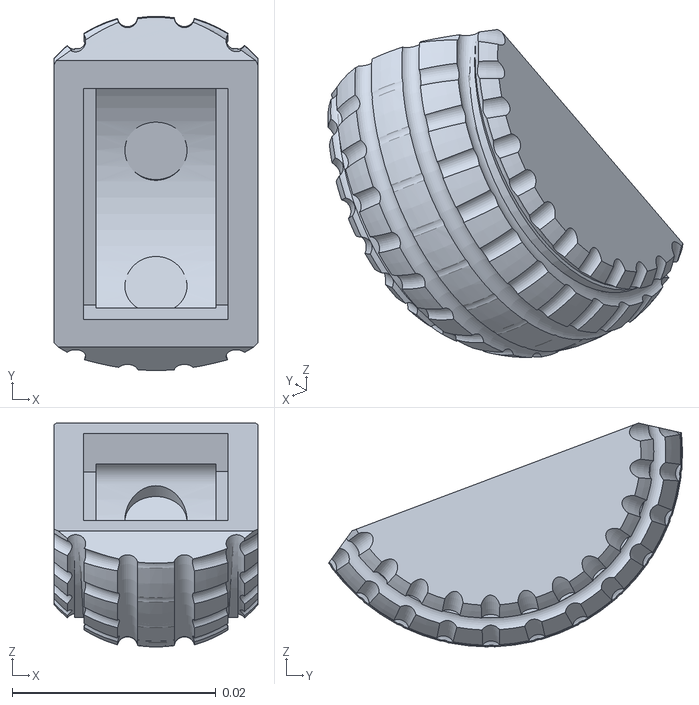
[picture p84: CAD file, 2020-09-23]
OpenQuad_V2/yellow_ros/src/mini_ros/stl/OpenQuadruped/LEFT_FOOT.stl
0.02 x 0.0348 x 0.022
