elpimous/yellow_robot/OpenQuad_V2/yellow_ros/src/mini_ros/stl/rfoot.stl

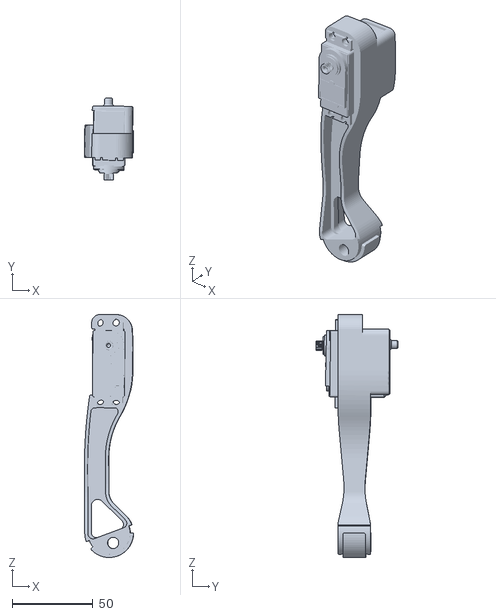
[picture p85: CAD file, 2020-09-23]
OpenQuad_V2/yellow_ros/src/mini_ros/stl/rfoot.stl
30.4 x 50.7 x 150.0
