elpimous/yellow_robot/OpenQuad_V2/robot_parts/body/body/front_in_plate_v2.STL

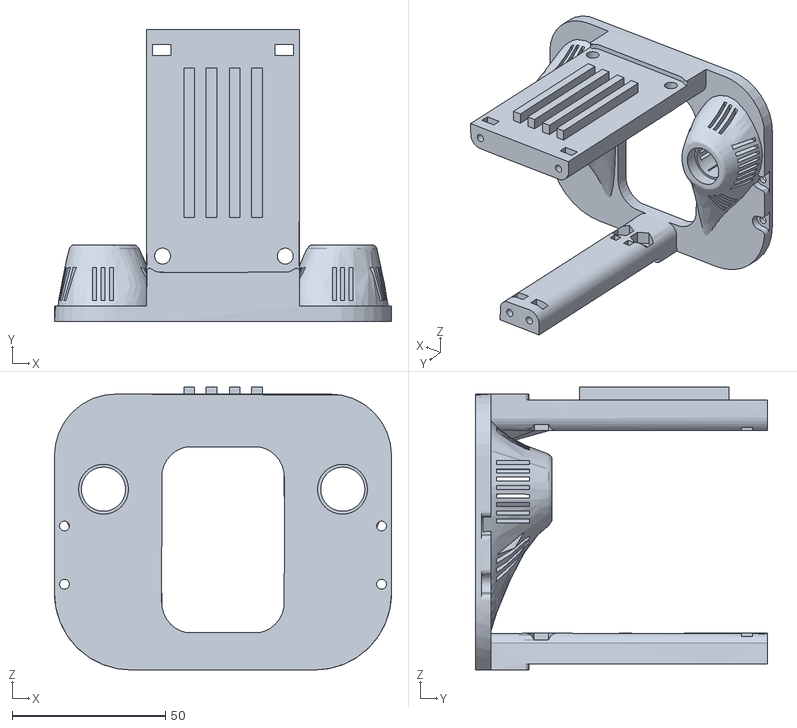
[picture p87: CAD file, 2020-08-23]
OpenQuad_V2/robot_parts/body/body/front_in_plate_v2.STL
109.8 x 95.1 x 92.2
