elpimous/yellow_robot/OpenQuad_V2/robot_parts/universel/foot.STL

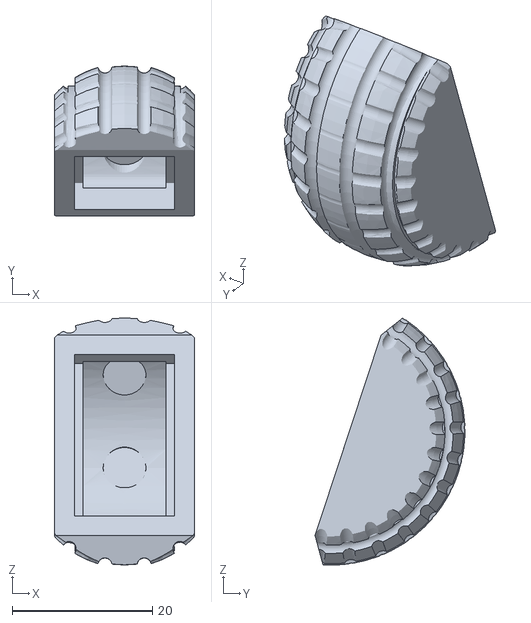
[picture p88: CAD file, 2020-08-23]
OpenQuad_V2/robot_parts/universel/foot.STL
20.0 x 21.4 x 35.2
