elpimous/yellow_robot/OpenQuad_V2/robot_parts/universel/stl_parts_for_3d_soft/HC-SR04P v1.stl

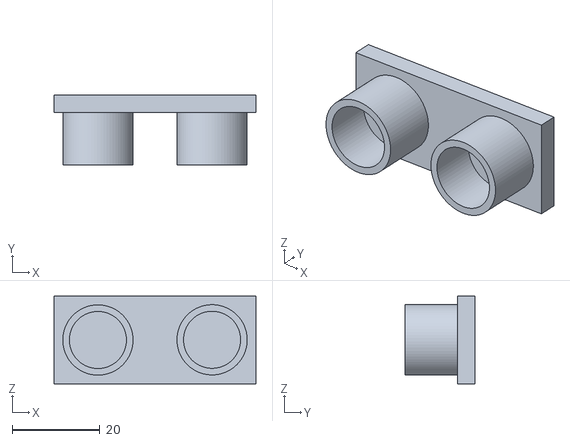
[picture p89: CAD file, 2020-08-23]
OpenQuad_V2/robot_parts/universel/stl_parts_for_3d_soft/HC-SR04P v1.stl
46.0 x 16.0 x 20.0
