elpimous/yellow_robot/OpenQuad_V2/yellow_ros/src/mini_ros/stl/OpenQuadruped/BATTERY.stl

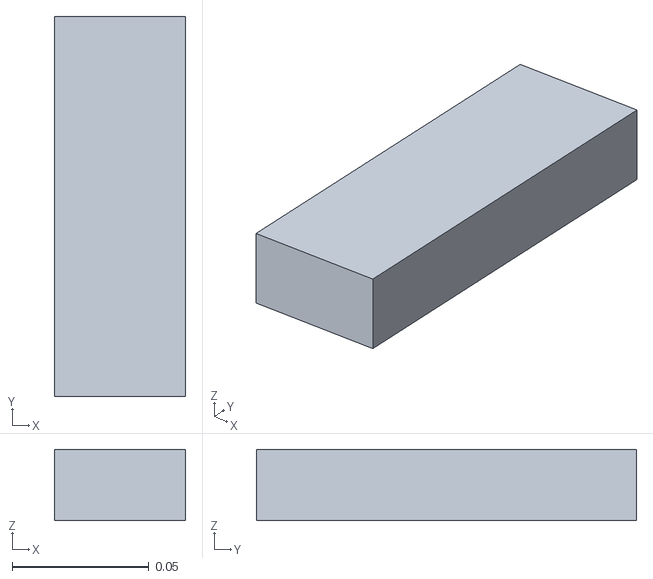
[picture p90: CAD file, 2020-09-23]
OpenQuad_V2/yellow_ros/src/mini_ros/stl/OpenQuadruped/BATTERY.stl
0.048 x 0.139 x 0.026
