elpimous/yellow_robot/OpenQuad_V2/robot_parts/body/body/back_in_plate_v2.STL

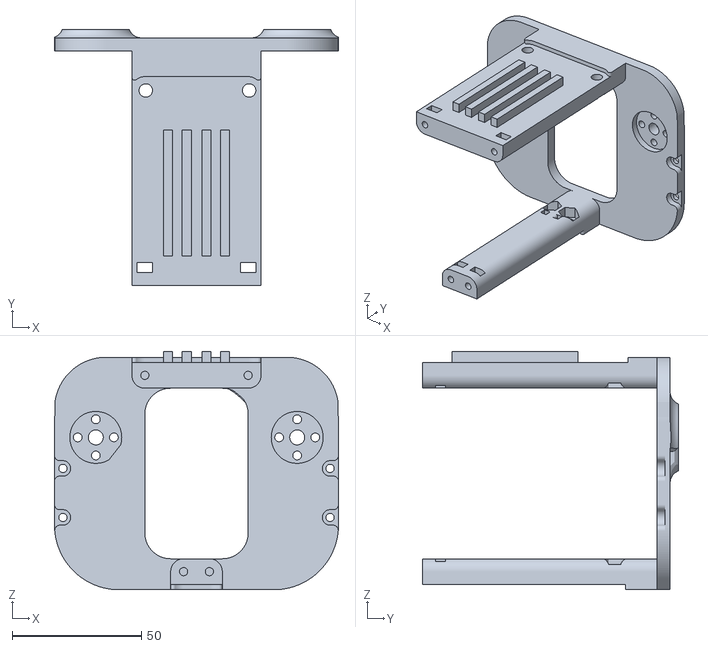
[picture p92: CAD file, 2020-08-23]
OpenQuad_V2/robot_parts/body/body/back_in_plate_v2.STL
110.0 x 99.1 x 92.4
