elpimous/yellow_robot/OpenQuad_V2/yellow_ros/src/mini_ros/stl/OpenQuadruped/RIGHT_UPPER_LEG.stl

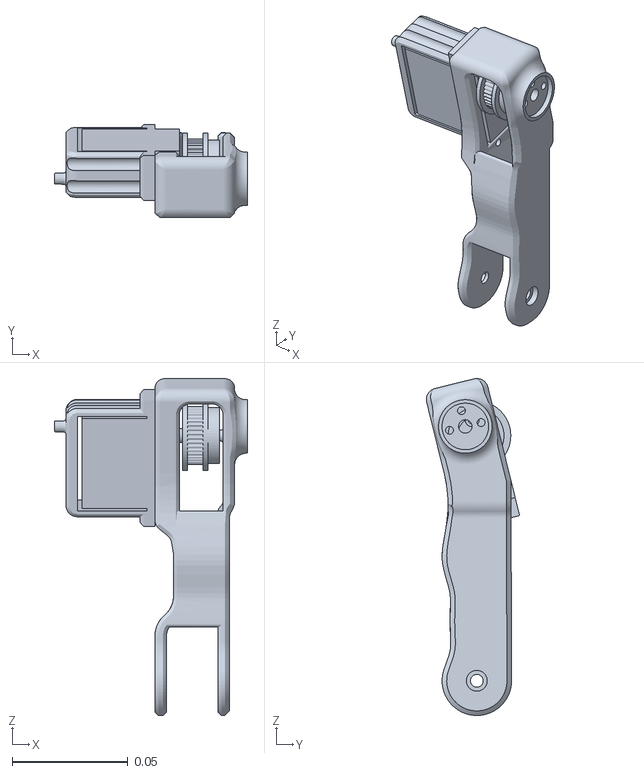
[picture p93: CAD file, 2020-09-23]
OpenQuad_V2/yellow_ros/src/mini_ros/stl/OpenQuadruped/RIGHT_UPPER_LEG.stl
0.0834 x 0.0403 x 0.145
