elpimous/yellow_robot/OpenQuad_V2/yellow_ros/src/mini_ros/stl/frontpart.stl

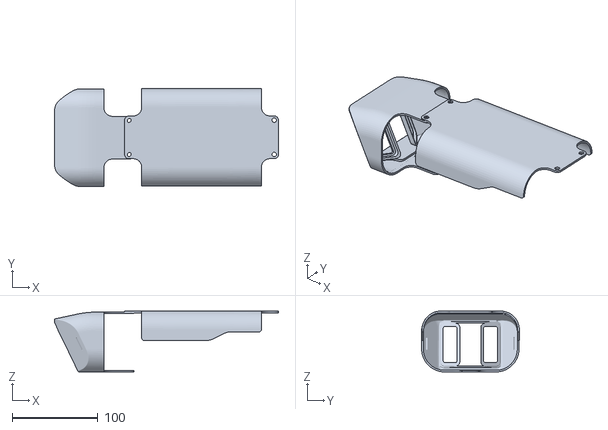
[picture p95: CAD file, 2020-09-23]
OpenQuad_V2/yellow_ros/src/mini_ros/stl/frontpart.stl
262.0 x 114.5 x 71.2
