elpimous/yellow_robot/OpenQuad_V2/yellow_ros/src/spotmicro/util/pybullet_data/assets/urdf/stl/OpenQuadruped/RIGHT_LOWER_LEG.stl

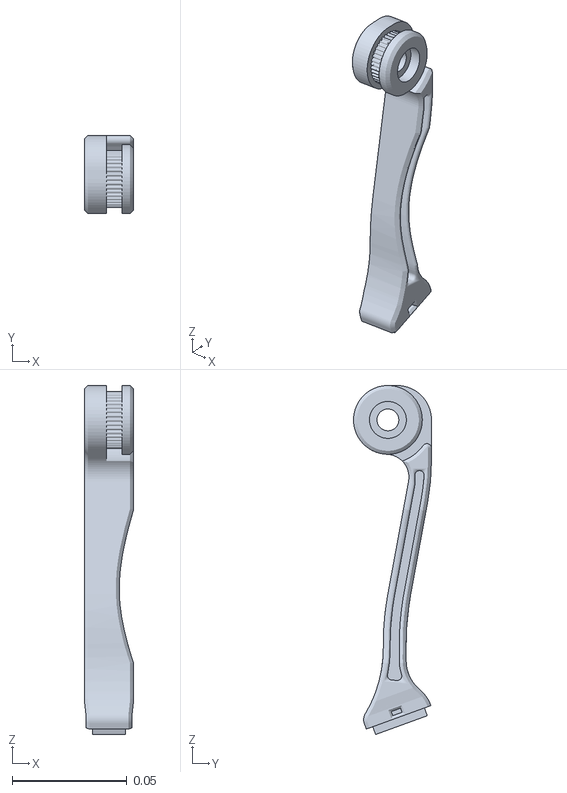
[picture p96: CAD file, 2020-09-23]
OpenQuad_V2/yellow_ros/src/spotmicro/util/pybullet_data/assets/urdf/stl/OpenQuadruped/RIGHT_LOWER_LEG.stl
0.0214 x 0.034 x 0.152
