elpimous/yellow_robot/(list of files, cad)

Other CAD files:
OpenQuad_V2/robot_parts/universel/foot_mold_for_V4_legs/mold_1-2.stl
OpenQuad_V2/yellow_ros/src/spotmicro/util/pybullet_data/assets/urdf/stl/OpenQuadruped/LEFT_HIP.stl
OpenQuad_V2/yellow_ros/src/spotmicro/util/pybullet_data/plane_transparent.obj
OpenQuad_V2/yellow_ros/src/spotmicro/util/pybullet_data/assets/urdf/stl/OpenQuadruped/Back_Bracket.stl
OpenQuad_V2/robot_parts/body/body/plateform_left_side_v2.stl
OpenQuad_V2/yellow_ros/src/mini_ros/stl/rear.stl
OpenQuad_V2/yellow_ros/src/spotmicro/util/pybullet_data/assets/urdf/stl/rarm_cover.stl
OpenQuad_V2/yellow_ros/src/mini_ros/stl/rarm_cover.stl
OpenQuad_V2/yellow_ros/src/spotmicro/util/pybullet_data/assets/urdf/stl/lfoot.stl
OpenQuad_V2/yellow_ros/src/mini_ros/stl/OpenQuadruped/LEFT_HIP.stl
OpenQuad_V2/yellow_ros/src/mini_ros/stl/OpenQuadruped/RIGHT_FOOT.stl
OpenQuad_V2/yellow_ros/src/spotmicro/util/pybullet_data/assets/urdf/stl/rear.stl
OpenQuad_V2/yellow_ros/src/mini_ros/stl/lfoot.stl
OpenQuad_V2/yellow_ros/src/spotmicro/util/pybullet_data/assets/urdf/stl/rshoulder.stl
OpenQuad_V2/yellow_ros/src/spotmicro/util/pybullet_data/assets/urdf/stl/OpenQuadruped/RIGHT_FOOT.stl
OpenQuad_V2/yellow_ros/src/mini_ros/stl/OpenQuadruped/Back_Bracket.stl
OpenQuad_V2/yellow_ros/src/mini_ros/stl/OpenQuadruped/LEFT_UPPER_LEG.stl
OpenQuad_V2/yellow_ros/src/mini_ros/stl/rarm.stl
OpenQuad_V2/yellow_ros/src/spotmicro/util/pybullet_data/assets/urdf/stl/OpenQuadruped/LEFT_UPPER_LEG.stl
OpenQuad_V2/yellow_ros/src/spotmicro/util/pybullet_data/assets/urdf/stl/rarm.stl
OpenQuad_V2/yellow_ros/src/mini_ros/stl/rshoulder.stl
OpenQuad_V2/robot_parts/body/body_cover/bottom_cover_v2_1-2.STL
OpenQuad_V2/robot_parts/universel/Shoulder_Pulley_for_v2.stl
OpenQuad_V2/yellow_ros/src/mini_ros/stl/OpenQuadruped/Back.stl
OpenQuad_V2/yellow_ros/src/mini_ros/stl/OpenQuadruped/Front.stl
OpenQuad_V2/yellow_ros/src/spotmicro/util/pybullet_data/assets/urdf/stl/OpenQuadruped/Back.stl
OpenQuad_V2/yellow_ros/src/spotmicro/util/pybullet_data/assets/urdf/stl/OpenQuadruped/Front.stl
