elpimous/yellow_robot/(commit log)

2020-08-23 first push
    [DS3218MG.step, DS3218MG_servo_object.STL, HC-SR04P v1.stl, RPI4+Mano_board_plateform_v2.STL, VIS_M5 v1.stl, back_cover_v2.STL, back_in_plate_v2.STL, back_out_plate_v2.STL]
2020-09-03 readme update, with BOM
2020-09-03 modified file structure
    [DS3218MG.step, DS3218MG_servo_object.STL, HC-SR04P v1.stl, RPI4+Mano_board_plateform_v2.STL, VIS_M5 v1.stl, back_cover_v2.STL, back_in_plate_v2.STL, back_out_plate_v2.STL]
2020-09-03 modified structure index
    [D435_fix_plate_v2.STL, DS3218MG.step, DS3218MG_servo_object.STL, HC-SR04P v1.stl, Neopixel8x.stl, RPI4+Mano_board_plateform_v2.STL, VIS_M5 v1.stl, back_cover_v2.STL]
2020-09-23 improve calibration visual
2020-09-27 modified_plate (error in assembly with sides !)
    [RPI4+Mano_board_plateform_v2.STL]
2020-09-28 missing file
    [Upper_leg_Pulley.stl]
2020-09-28 diageam of teensy4.1 added
2020-10-11 add cover !
    [front_cover_v2.STL]
2020-10-11 New SILICON mold HOWTO for Legs_V4 ONLY !
2020-10-18 new_legs V4 !! ATTENTION, pulleys and timing belt are different !
    [L_leg_1-2.stl, L_leg_2-2.stl, R_leg_1-2.stl, R_leg_2-2.stl, R_shoulder_1-2.stl, R_shoulder_2-2.stl, R_shoulder_cover.stl, shoulder_pulley_for_V4.stl]
2020-10-21 adding legpulley for V4 legs
    [leg_pulley_for_V4.stl]
